goran-mahovlic/Pi5-Artix-FPGA-Hat/PCB/outputs/Pi5-Artix50T-Hat.pdf

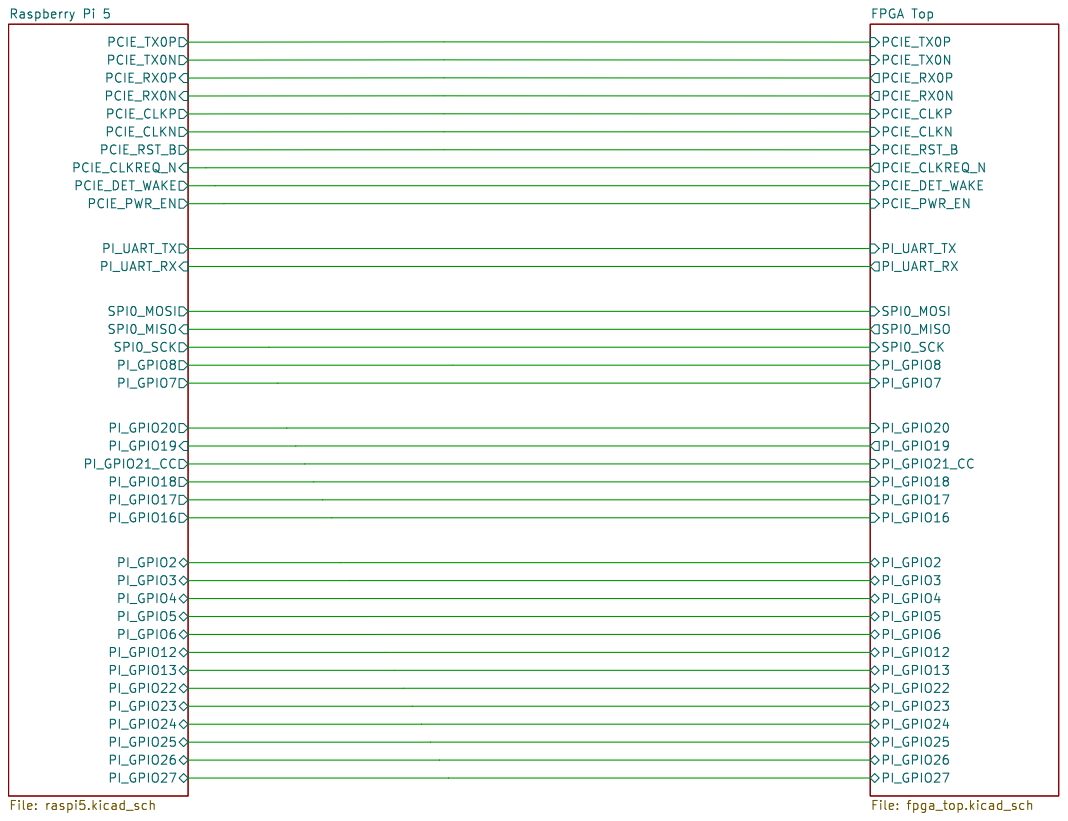
[picture p1: page 1]

https://www.george-smart.co.uk
https://github.com/m1geo/Pi5-Artix-FPGA-Hat

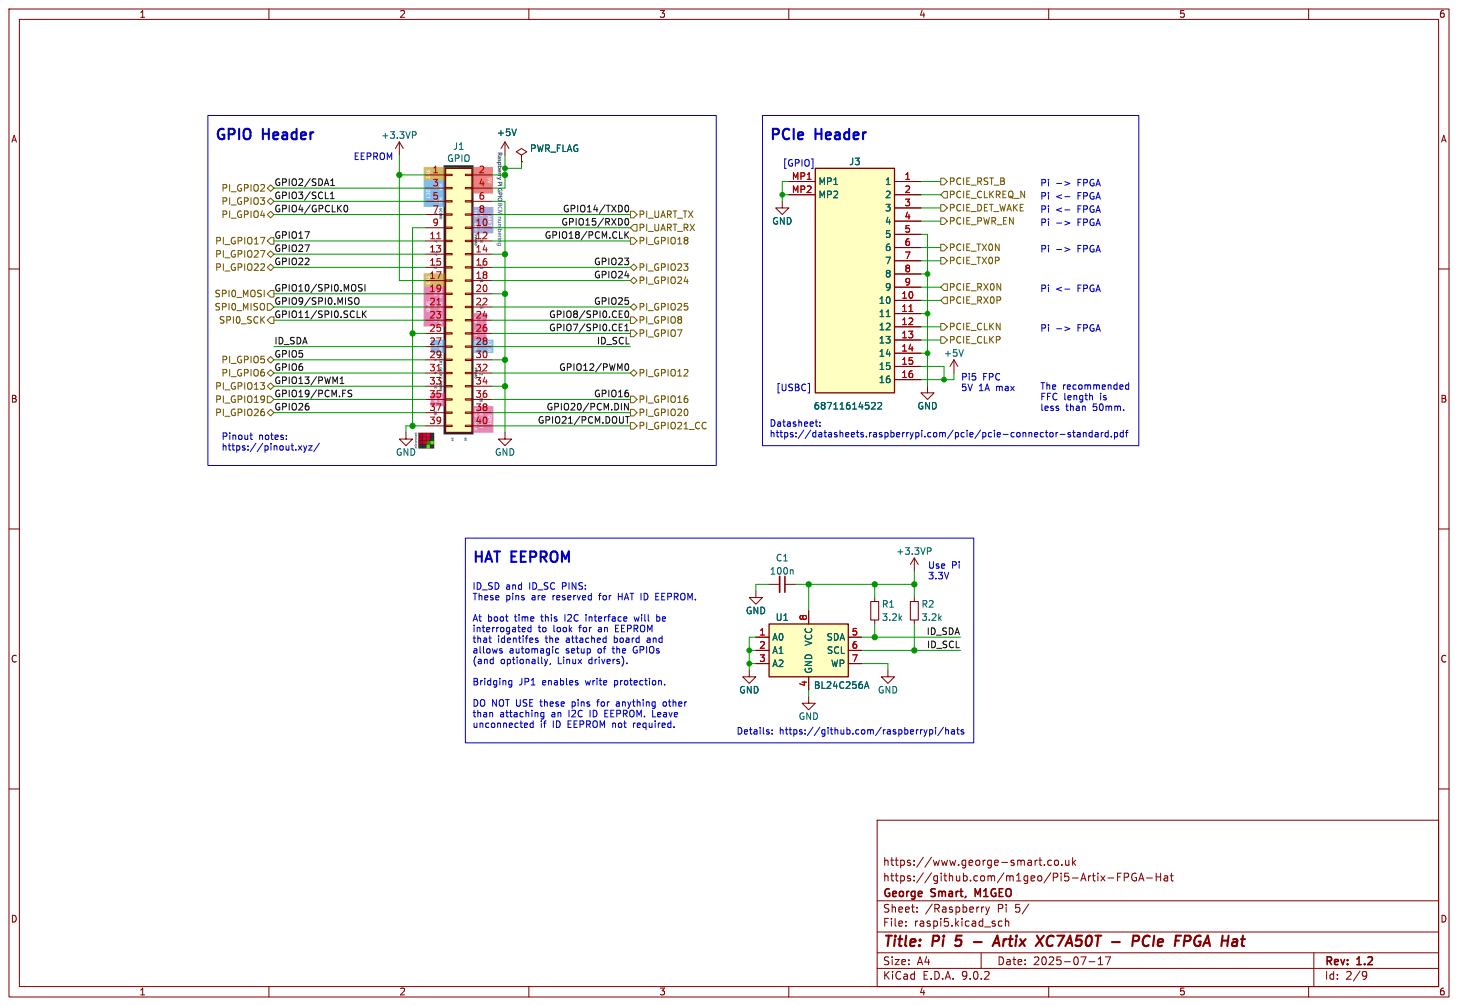
[picture p2: page 2]

4 SDA 5 SCL 6 WP 7 GND GND

The recommended FFC length is

Pinout notes: https://pinout.xyz/

3.2k +3.3VP GND
Details: https://github.com/raspberrypi/hats Use Pi 3.3V

4 SDA 5 SCL 6 WP 7 U1 BL24C256A GND GND

https://github.com/m1geo/Pi5-Artix-FPGA-Hat

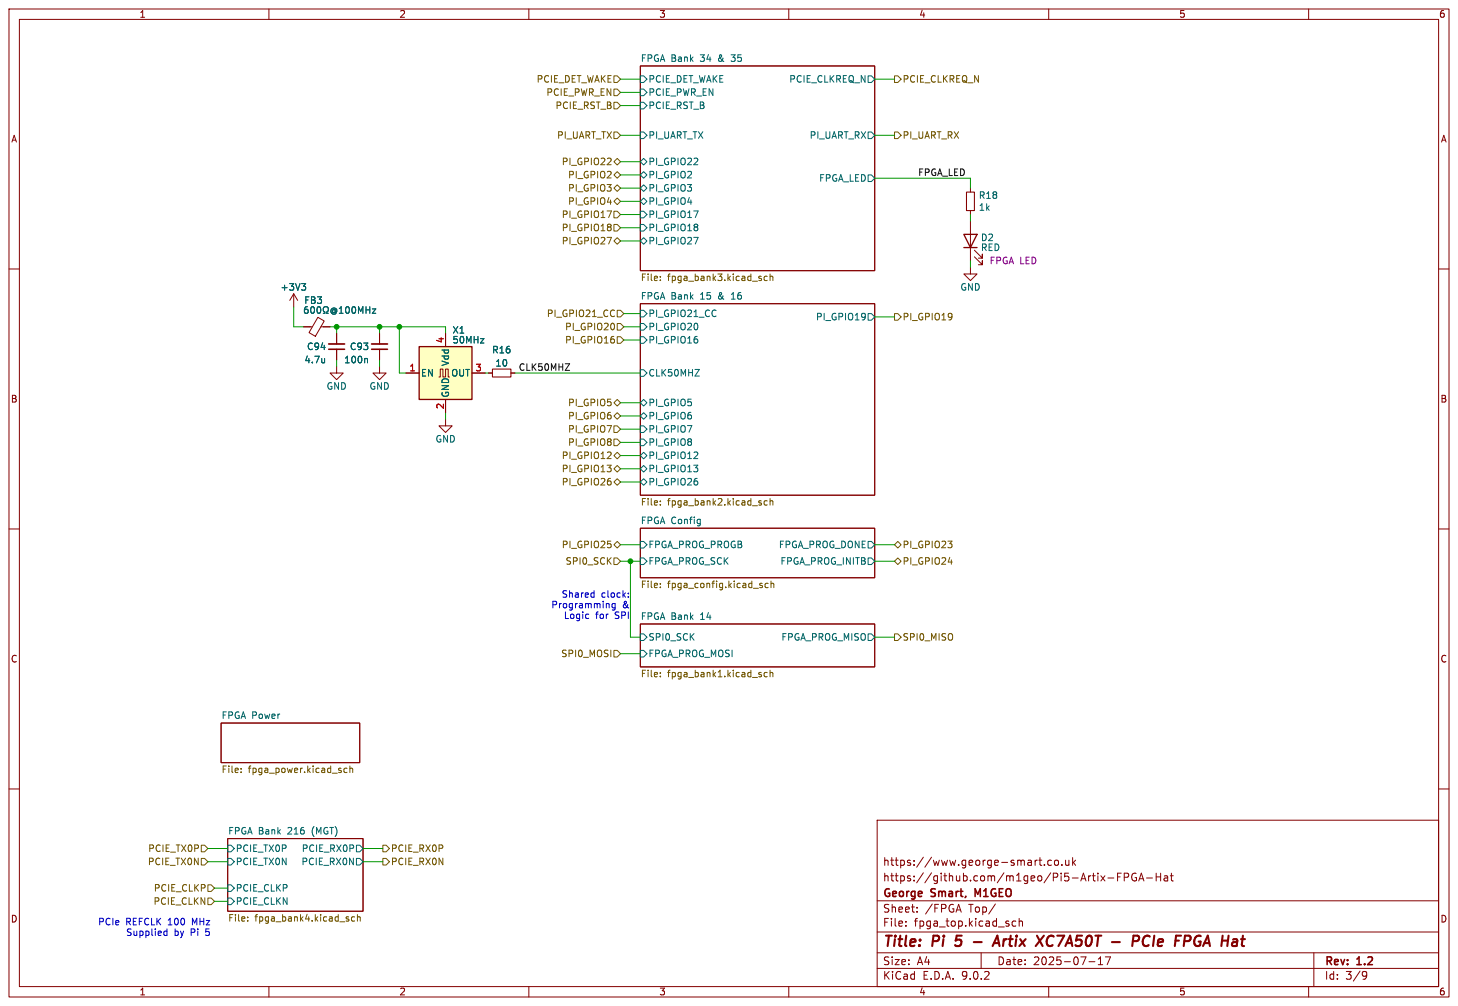
[picture p3: page 3]

Id: 3/9 Title: Pi 5 - Artix XC7A50T - PCIe FPGA Hat File: fpga_top.kicad_sch Sheet: /FPGA Top/

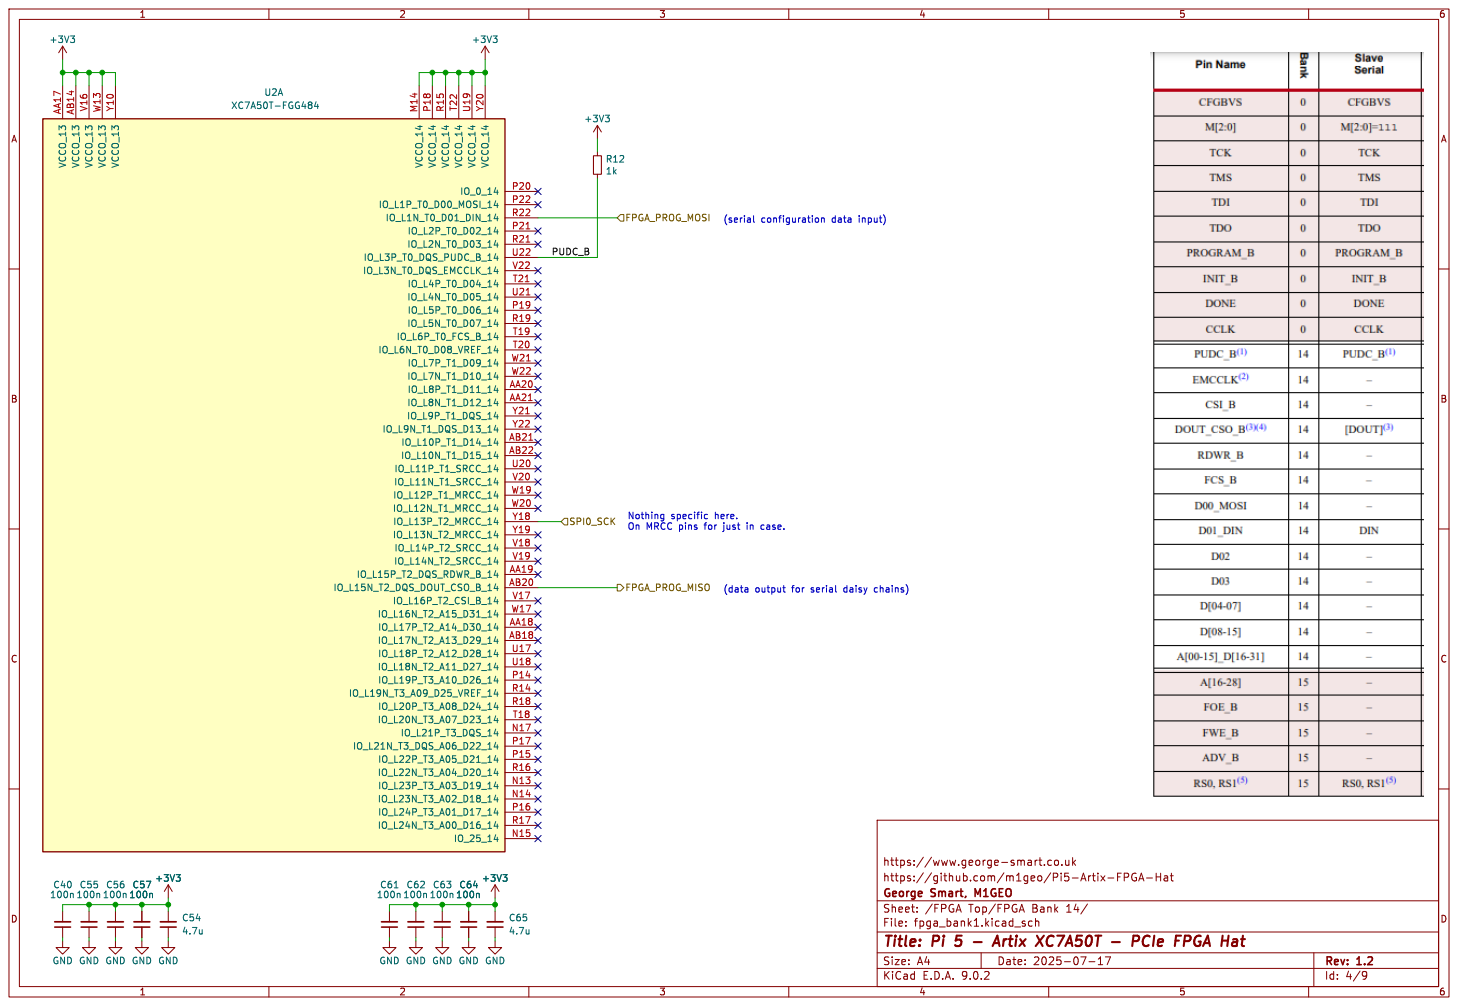
[picture p4: page 4]

https://www.george-smart.co.uk GND

https://github.com/m1geo/Pi5-Artix-FPGA-Hat

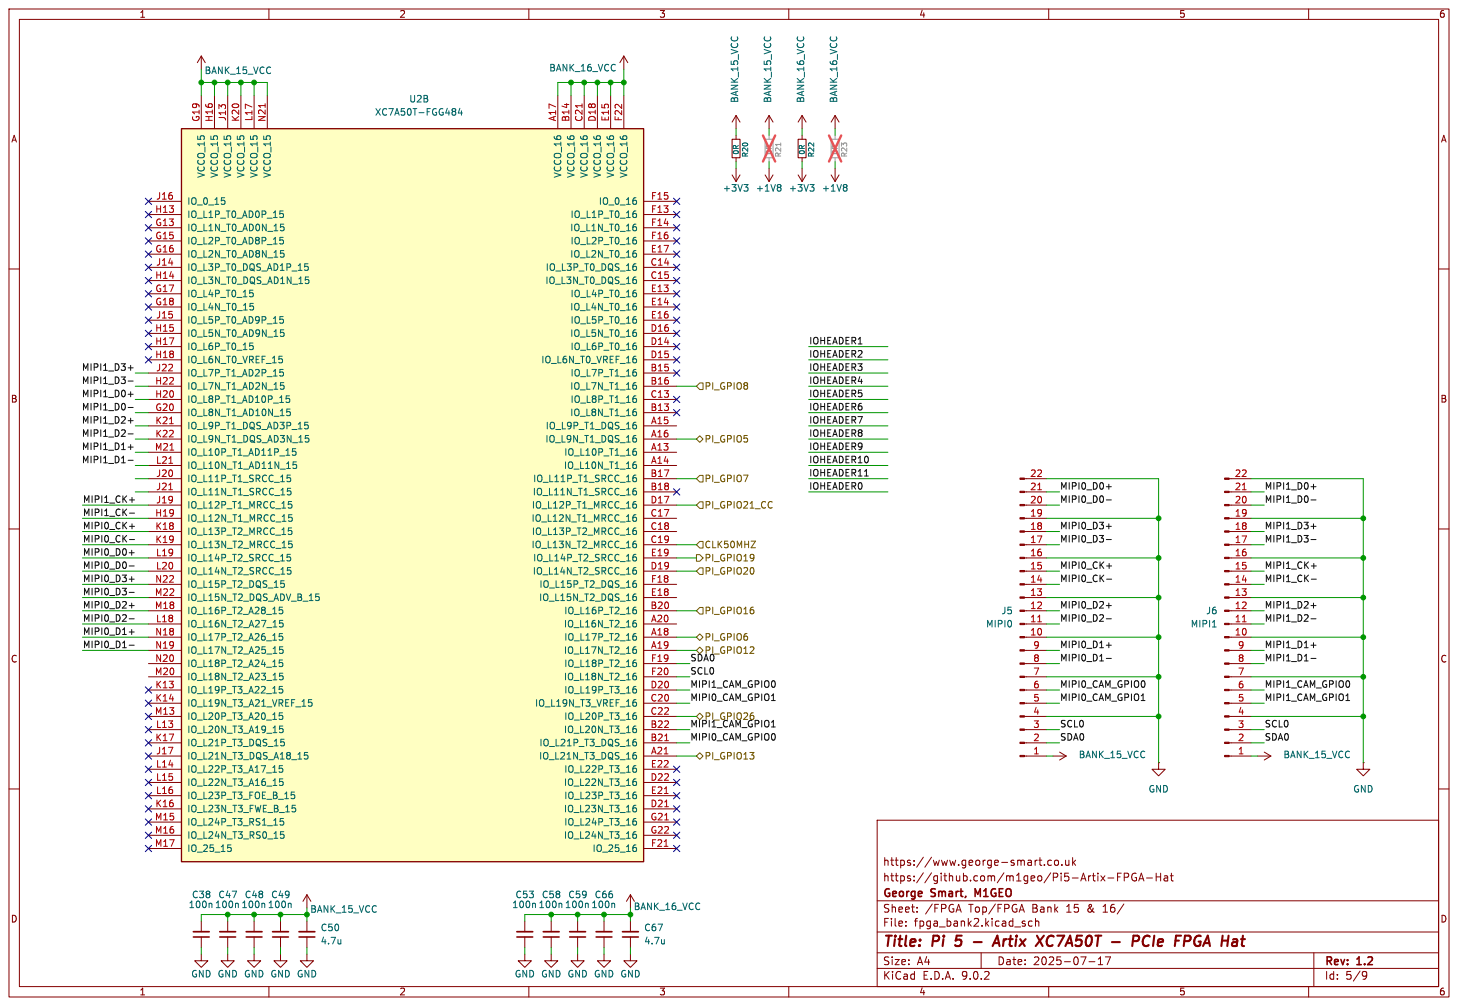
[picture p5: page 5]

https://www.george-smart.co.uk C38

https://github.com/m1geo/Pi5-Artix-FPGA-Hat

GND GND GND GND GND

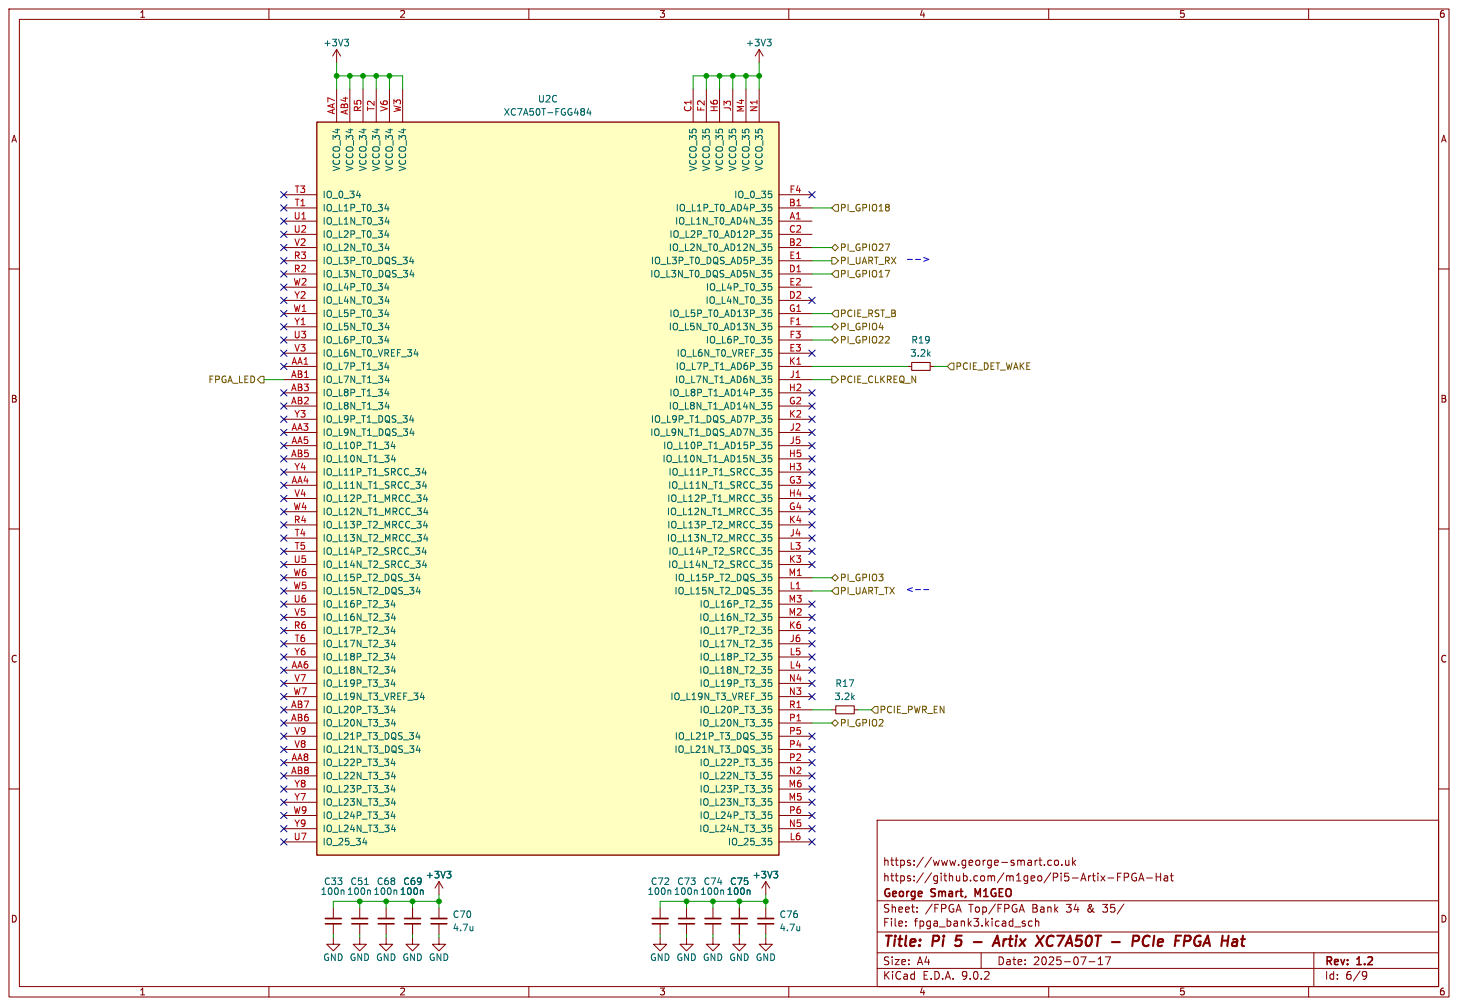
[picture p6: page 6]

https://github.com/m1geo/Pi5-Artix-FPGA-Hat

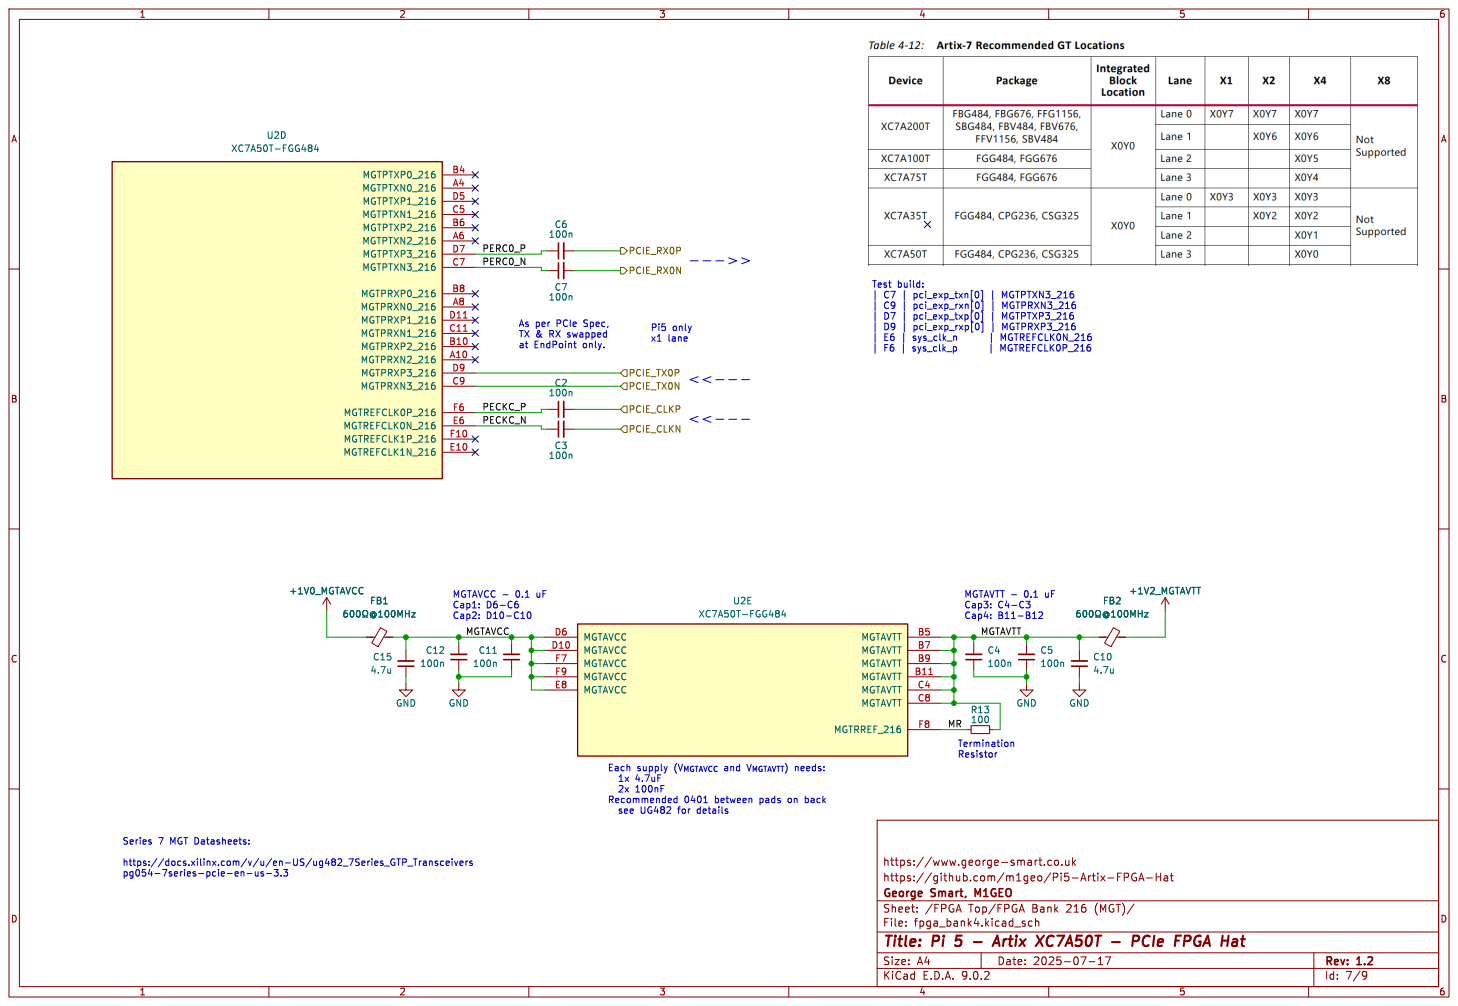
[picture p7: page 7]

As per PCIe Spec, TX & RX swapped

x1 lane Series 7 MGT Datasheets: https://docs.xilinx.com/v/u/en-US/ug482_7Series_GTP_Transceivers

https://www.george-smart.co.uk C3

https://github.com/m1geo/Pi5-Artix-FPGA-Hat

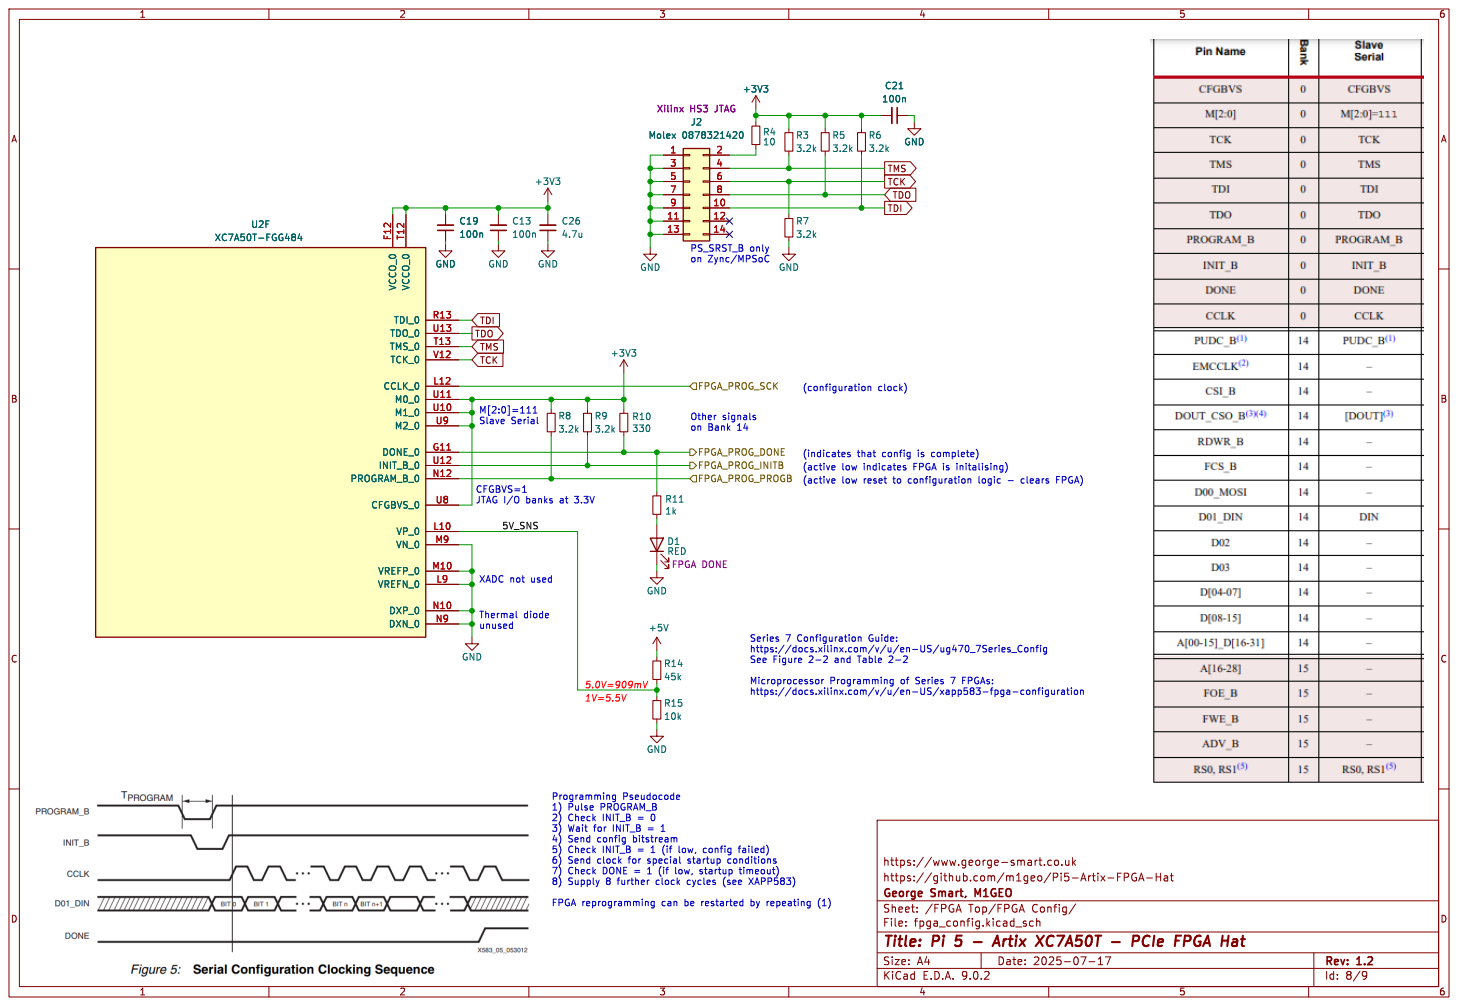
[picture p8: page 8]

https://www.george-smart.co.uk R8

1) Pulse PROGRAM_B
2) Check INIT_B = 0
3) Wait for INIT_B = 1
4) Send config bitstream
5) Check INIT_B = 1 (if low, config failed)
6) Send clock for special startup conditions 7) Check DONE = 1 (if low, startup timeout)

https://github.com/m1geo/Pi5-Artix-FPGA-Hat
Id: 8/9 Title: Pi 5 - Artix XC7A50T - PCIe FPGA Hat File: fpga_config.kicad_sch Sheet: /FPGA Top/FPGA Config/

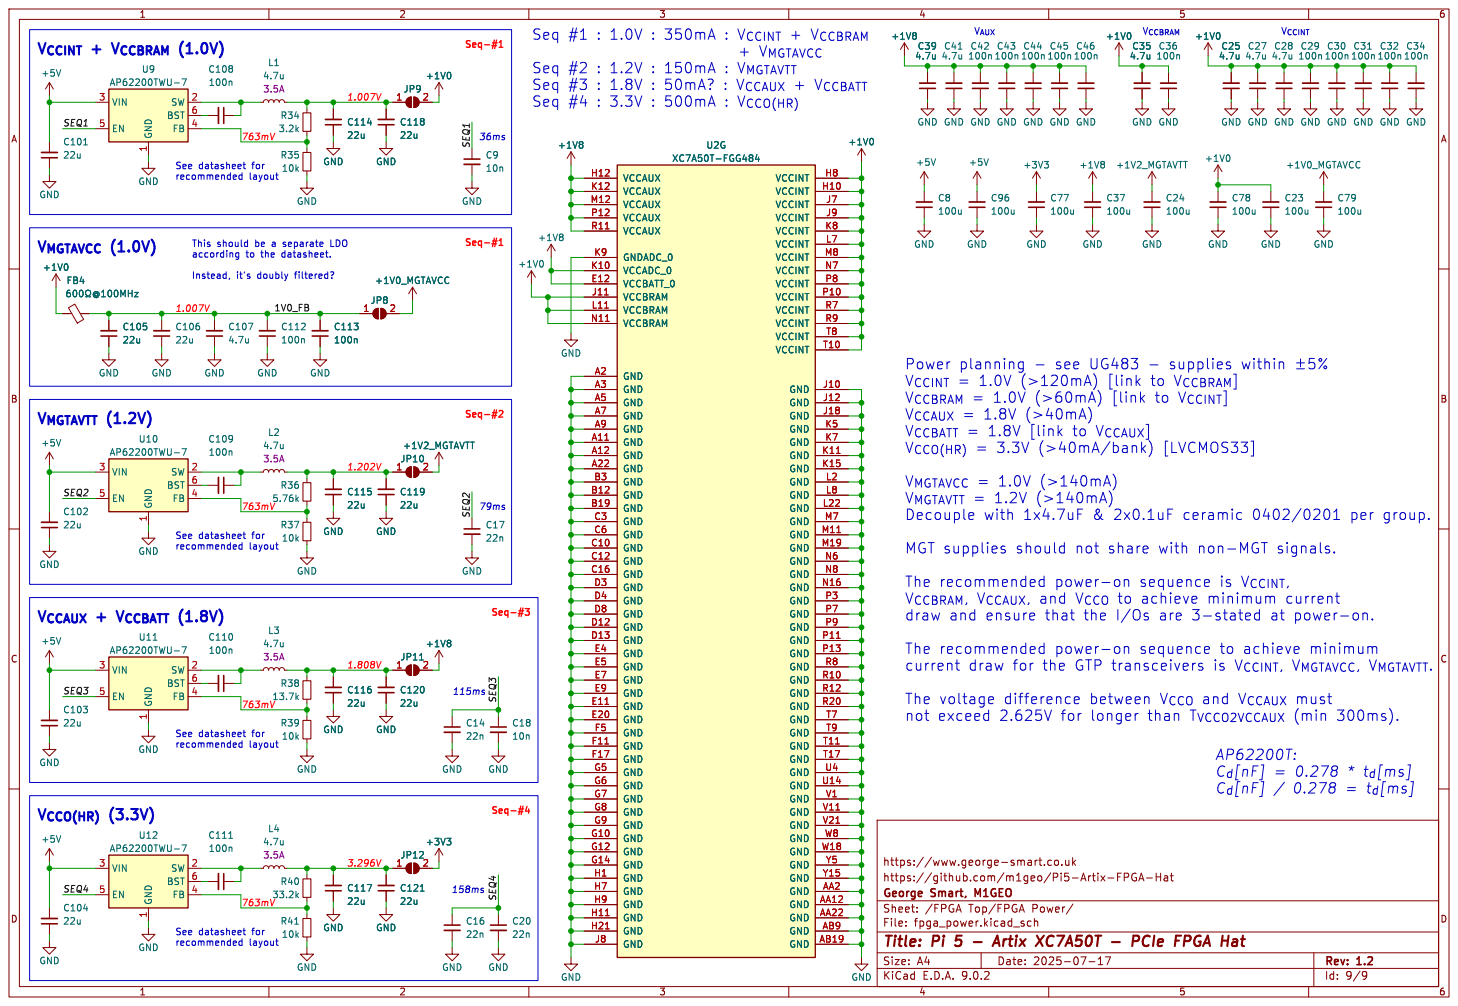
[picture p9: page 9]

1 SW 2 BST 6 FB 4 U9 AP62200TWU-7 GND GND

V_{CCAUX} = 1.8V (>40mA)
V_{CCBATT} = 1.8V [link to V_{CCAUX}]

1 SW 2 BST 6 FB 4 U12 AP62200TWU-7 GND

MGT supplies should not share with non-MGT signals.

V_{CCBRAM}, V_{CCAUX}, and V_{CCO} to achieve minimum current

1 SW 2 BST 6 FB 4 U11 AP62200TWU-7 GND

not exceed 2.625V for longer than T_{VCCO2VCCAUX} (min 300ms).

https://www.george-smart.co.uk
https://github.com/m1geo/Pi5-Artix-FPGA-Hat
