goran-mahovlic/Pi5-Artix-FPGA-Hat/PCB/Pi5-Artix50T-Hat.kicad_pcb

## KiCad design PCB/Pi5-Artix50T-Hat.kicad_pcb (2025-07-19)

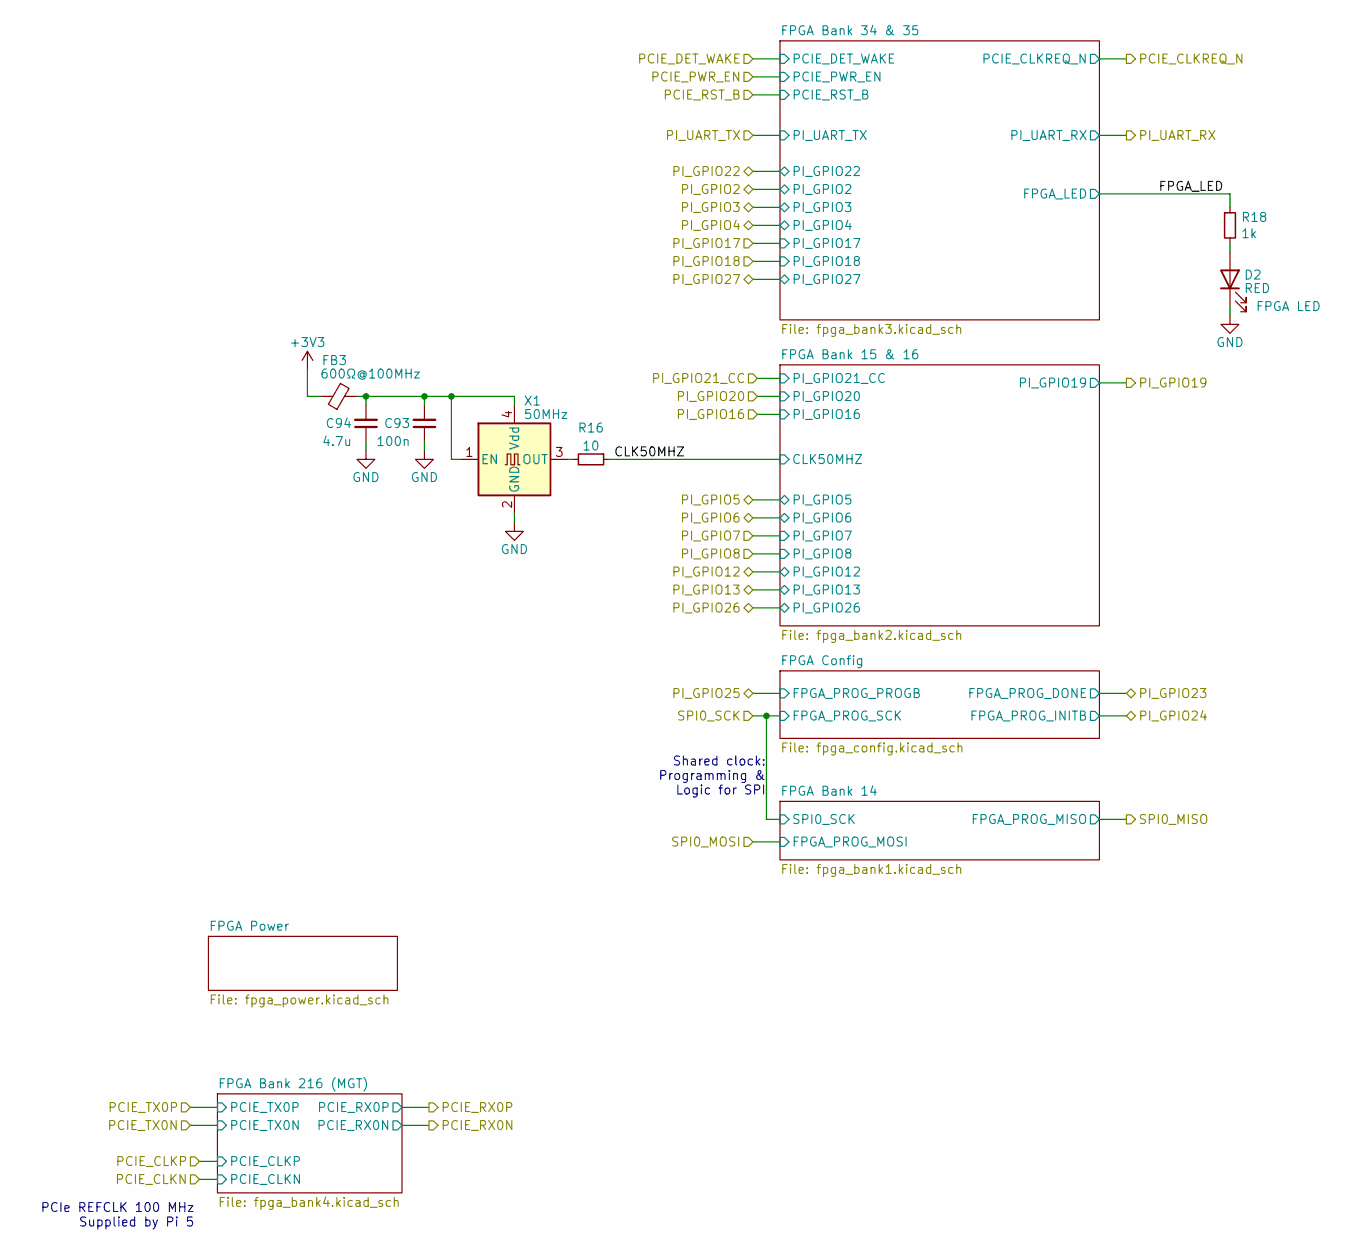
[picture p10: schematic fpga_top.kicad_sch, Pi 5 - Artix XC7A50T - PCIe FPGA Hat]

Parts:
C93: 100n; C_0402_1005Metric; LCSC C1525
C94: 4.7u; C_0402_1005Metric; LCSC C23733
D2: RED; LED_0603_1608Metric; LCSC C965795
FB3: 600Ω@100MHz; L_0603_1608Metric; LCSC C1002
R16: 10; R_0402_1005Metric; LCSC C25077
R18: 1k; R_0402_1005Metric; LCSC C11702
X1: 50MHz; Oscillator_SMD_EuroQuartz_XO32-4Pin_3.2x2.5mm; LCSC C5203552

Connections:
+3V3: FB3.1; also elsewhere on the board
/FPGA Top/CLK50MHZ: R16.1; also elsewhere on the board
/FPGA Top/FPGA_LED: R18.1; also elsewhere on the board
GND: C93.1, C94.1, D2.1 (K), X1.2 (GND); also elsewhere on the board
unnamed: D2.2 (A), R18.2
unnamed: C93.2, C94.2, FB3.2, X1.1 (EN), X1.4 (Vdd)
unnamed: R16.2, X1.3 (OUT)

Notes on the sheet:
Shared clock: Programming & Logic for SPI
PCIe REFCLK 100 MHz Supplied by Pi 5

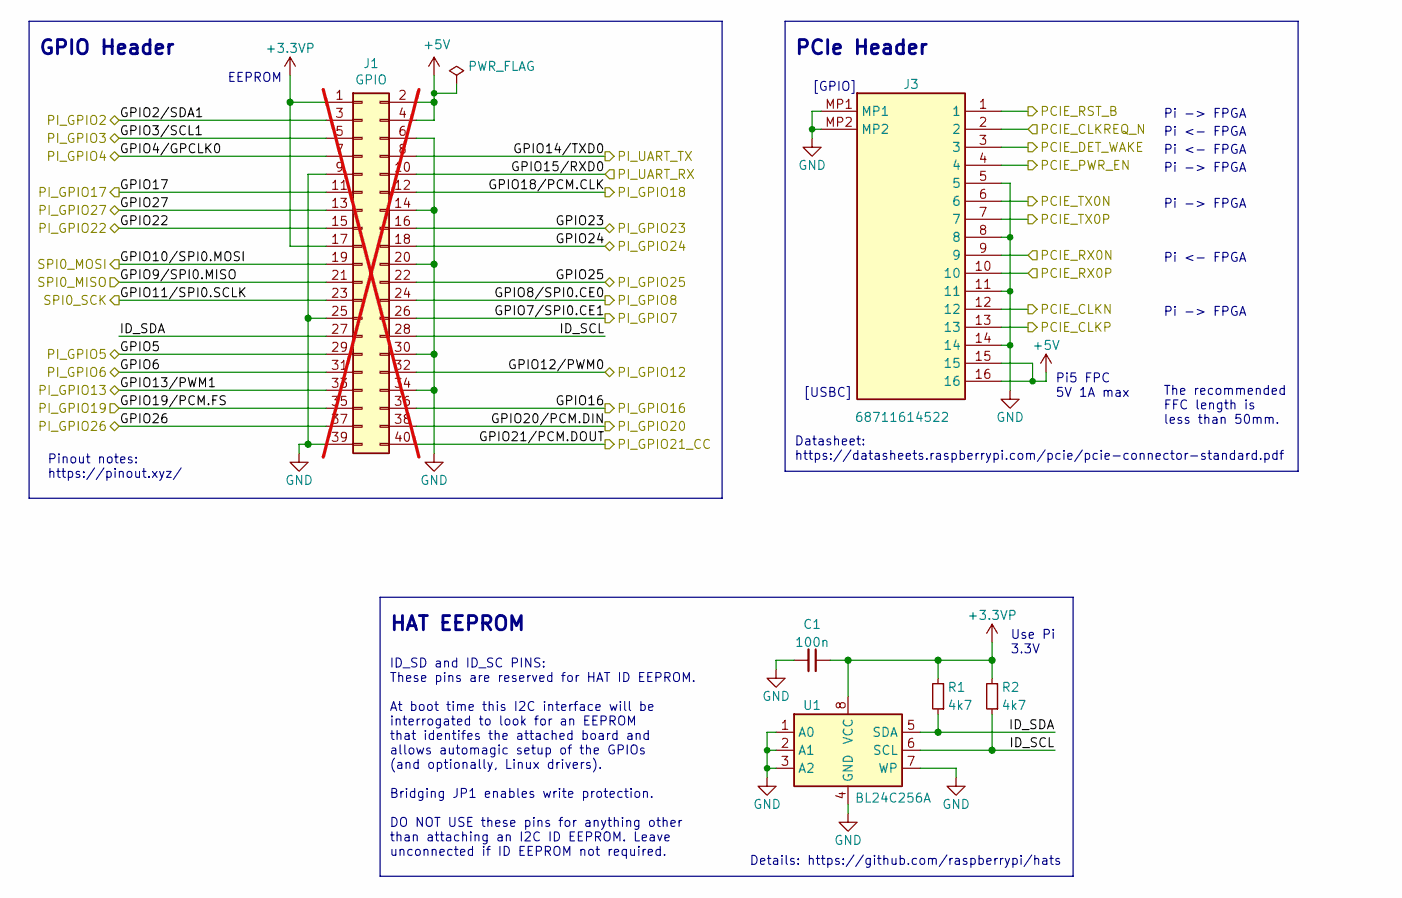
[picture p11: schematic raspi5.kicad_sch, Pi 5 - Artix XC7A50T - PCIe FPGA Hat]

Parts:
C1: 100n; C_0402_1005Metric; LCSC C1525
J1: GPIO; PinSocket_2x20_P2.54mm_Vertical; LCSC C2977589; not fitted
J3: 68711614522; Manufacturer_Part_Number 68711614522; Mouser Part Number 710-68711614522
R1, R2: 4k7; R_0402_1005Metric; LCSC C25900
U1: BL24C256A; TSSOP-8_4.4x3mm_P0.65mm; LCSC C110276

Connections:
+3.3VP: C1.1, J1.1, J1.17, R1.2, R2.2, U1.8 (VCC)
+5V: J1.2, J1.4, J3.15, J3.16; also elsewhere on the board
/FPGA Top/PCIE_CLKN: J3.12; also elsewhere on the board
/FPGA Top/PCIE_CLKP: J3.13; also elsewhere on the board
/FPGA Top/PCIE_CLKREQ_N: J3.2; also elsewhere on the board
/FPGA Top/PCIE_DET_WAKE: J3.3; also elsewhere on the board
/FPGA Top/PCIE_PWR_EN: J3.4; also elsewhere on the board
/FPGA Top/PCIE_RST_B: J3.1; also elsewhere on the board
/FPGA Top/PCIE_RX0N: J3.9; also elsewhere on the board
/FPGA Top/PCIE_RX0P: J3.10; also elsewhere on the board
/FPGA Top/PCIE_TX0N: J3.6; also elsewhere on the board
/FPGA Top/PCIE_TX0P: J3.7; also elsewhere on the board
/Raspberry Pi 5/GPIO2/SDA1: J1.3; also elsewhere on the board
/Raspberry Pi 5/GPIO3/SCL1: J1.5; also elsewhere on the board
/Raspberry Pi 5/GPIO4/GPCLK0: J1.7; also elsewhere on the board
/Raspberry Pi 5/GPIO5: J1.29; also elsewhere on the board
/Raspberry Pi 5/GPIO6: J1.31; also elsewhere on the board
/Raspberry Pi 5/GPIO7/SPI0.CE1: J1.26; also elsewhere on the board
/Raspberry Pi 5/GPIO8/SPI0.CE0: J1.24; also elsewhere on the board
/Raspberry Pi 5/GPIO9/SPI0.MISO: J1.21; also elsewhere on the board
/Raspberry Pi 5/GPIO10/SPI0.MOSI: J1.19; also elsewhere on the board
/Raspberry Pi 5/GPIO11/SPI0.SCLK: J1.23; also elsewhere on the board
/Raspberry Pi 5/GPIO12/PWM0: J1.32; also elsewhere on the board
/Raspberry Pi 5/GPIO13/PWM1: J1.33; also elsewhere on the board
/Raspberry Pi 5/GPIO14/TXD0: J1.8; also elsewhere on the board
/Raspberry Pi 5/GPIO15/RXD0: J1.10; also elsewhere on the board
/Raspberry Pi 5/GPIO16: J1.36; also elsewhere on the board
/Raspberry Pi 5/GPIO17: J1.11; also elsewhere on the board
/Raspberry Pi 5/GPIO18/PCM.CLK: J1.12; also elsewhere on the board
/Raspberry Pi 5/GPIO19/PCM.FS: J1.35; also elsewhere on the board
/Raspberry Pi 5/GPIO20/PCM.DIN: J1.38; also elsewhere on the board
/Raspberry Pi 5/GPIO21/PCM.DOUT: J1.40; also elsewhere on the board
/Raspberry Pi 5/GPIO22: J1.15; also elsewhere on the board
/Raspberry Pi 5/GPIO23: J1.16; also elsewhere on the board
/Raspberry Pi 5/GPIO24: J1.18; also elsewhere on the board
/Raspberry Pi 5/GPIO25: J1.22; also elsewhere on the board
/Raspberry Pi 5/GPIO26: J1.37; also elsewhere on the board
/Raspberry Pi 5/GPIO27: J1.13; also elsewhere on the board
/Raspberry Pi 5/ID_SCL: J1.28, R2.1, U1.6 (SCL)
/Raspberry Pi 5/ID_SDA: J1.27, R1.1, U1.5 (SDA)
GND: C1.2, J1.6, J1.9, J1.14, J1.20, J1.25, J1.30, J1.34, J1.39, J3.5, J3.8, J3.11, J3.14, J3.MP1, J3.MP2, U1.1 (A0), U1.2 (A1), U1.3 (A2), U1.4 (GND), U1.7 (WP); also elsewhere on the board

Notes on the sheet:
Pi <- FPGA
[USBC]
Pinout notes: https://pinout.xyz/
Pi -> FPGA
EEPROM
[GPIO]
The recommended FFC length is less than 50mm.
PCIe Header
ID_SD and ID_SC PINS: These pins are reserved for HAT ID EEPROM. At boot time this I2C interface will be interrogated to look for an EEPROM that identifes the attached board and allows automagic setup of the GPIOs (and optionally, Linux drivers). Bridging JP1 enables write protection. DO NOT USE th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
HAT EEPROM
Datasheet: https://datasheets.raspberrypi.com/pcie/pcie-connector-standard.pdf
Details: https://github.com/raspberrypi/hats
Use Pi 3.3V
Pi5 FPC 5V 1A max
GPIO Header

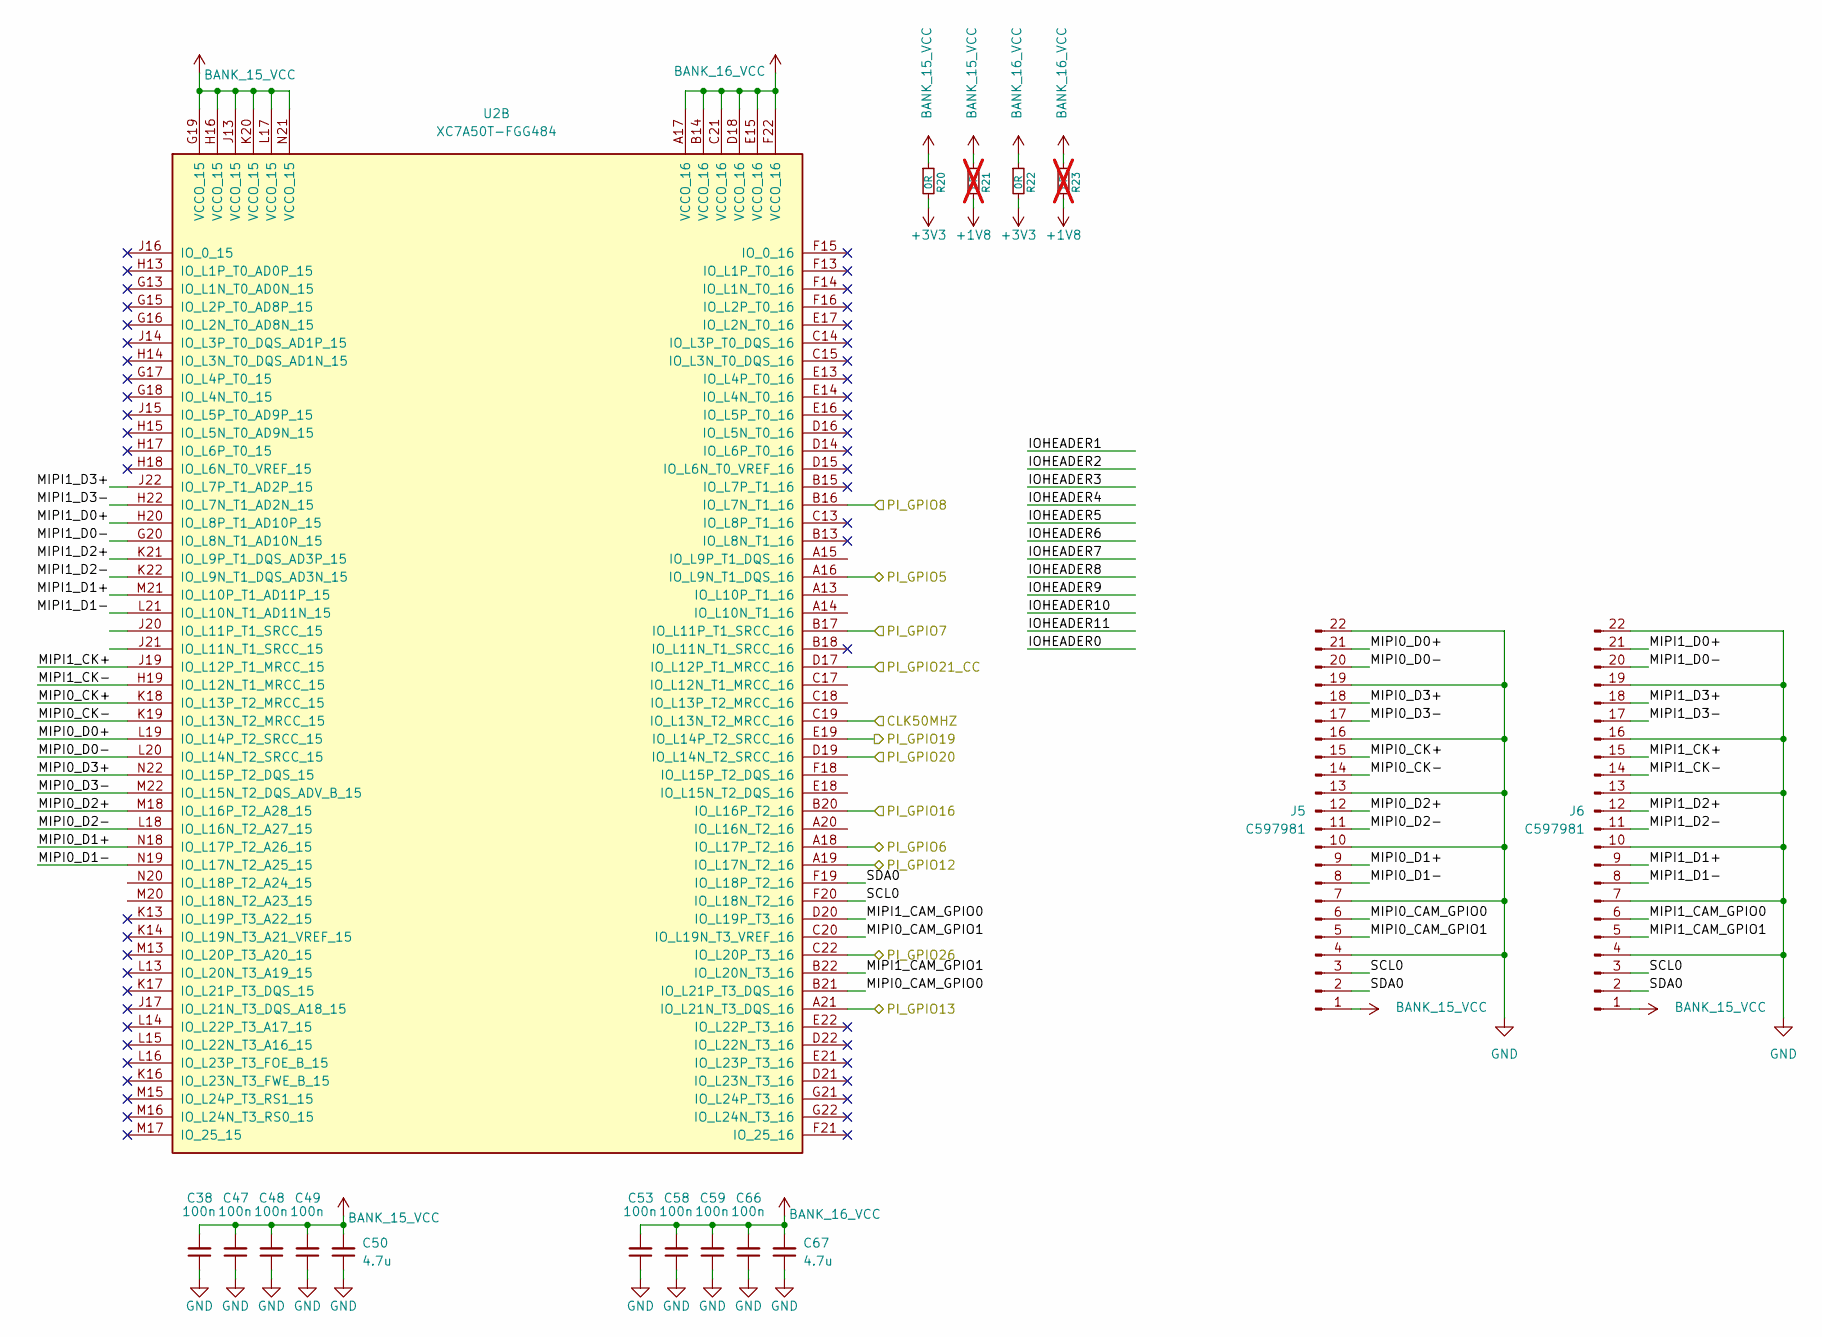
[picture p12: schematic fpga_bank2.kicad_sch, Pi 5 - Artix XC7A50T - PCIe FPGA Hat]

Parts:
C38, C47, C48, C49, C53, C58, C59, C66: 100n; C_0402_1005Metric; LCSC C1525
C50, C67: 4.7u; C_0402_1005Metric; LCSC C23733
J5, J6: C597981; CONN_FH12-22S-0.5SH55_HIR; LCSC C597981
R20, R22: 0R; R_0603_1608Metric
R21, R23: 0R; R_0603_1608Metric; not fitted
U2: XC7A50T-FGG484; Xilinx_FGG484; LCSC C1550658

Connections:
+1V8: R21.2, R23.2; also elsewhere on the board
+3V3: R20.2, R22.2; also elsewhere on the board
/FPGA Top/CLK50MHZ: U2.C19 (IO_L13N_T2_MRCC_16); also elsewhere on the board
/FPGA Top/FPGA Bank 15 & 16/MIPI0_CAM_GPIO0: J5.6, U2.B21 (IO_L21P_T3_DQS_16)
/FPGA Top/FPGA Bank 15 & 16/MIPI0_CAM_GPIO1: J5.5, U2.C20 (IO_L19N_T3_VREF_16)
/FPGA Top/FPGA Bank 15 & 16/MIPI0_CK+: J5.15, U2.K18 (IO_L13P_T2_MRCC_15)
/FPGA Top/FPGA Bank 15 & 16/MIPI0_CK-: J5.14, U2.K19 (IO_L13N_T2_MRCC_15)
/FPGA Top/FPGA Bank 15 & 16/MIPI0_D0+: J5.21, U2.L19 (IO_L14P_T2_SRCC_15)
/FPGA Top/FPGA Bank 15 & 16/MIPI0_D0-: J5.20, U2.L20 (IO_L14N_T2_SRCC_15)
/FPGA Top/FPGA Bank 15 & 16/MIPI0_D1+: J5.9, U2.N18 (IO_L17P_T2_A26_15)
/FPGA Top/FPGA Bank 15 & 16/MIPI0_D1-: J5.8, U2.N19 (IO_L17N_T2_A25_15)
/FPGA Top/FPGA Bank 15 & 16/MIPI0_D2+: J5.12, U2.M18 (IO_L16P_T2_A28_15)
/FPGA Top/FPGA Bank 15 & 16/MIPI0_D2-: J5.11, U2.L18 (IO_L16N_T2_A27_15)
/FPGA Top/FPGA Bank 15 & 16/MIPI0_D3+: J5.18, U2.N22 (IO_L15P_T2_DQS_15)
/FPGA Top/FPGA Bank 15 & 16/MIPI0_D3-: J5.17, U2.M22 (IO_L15N_T2_DQS_ADV_B_15)
/FPGA Top/FPGA Bank 15 & 16/MIPI1_CAM_GPIO0: J6.6, U2.D20 (IO_L19P_T3_16)
/FPGA Top/FPGA Bank 15 & 16/MIPI1_CAM_GPIO1: J6.5, U2.B22 (IO_L20N_T3_16)
/FPGA Top/FPGA Bank 15 & 16/MIPI1_CK+: J6.15, U2.J19 (IO_L12P_T1_MRCC_15)
/FPGA Top/FPGA Bank 15 & 16/MIPI1_CK-: J6.14, U2.H19 (IO_L12N_T1_MRCC_15)
/FPGA Top/FPGA Bank 15 & 16/MIPI1_D0+: J6.21, U2.H20 (IO_L8P_T1_AD10P_15)
/FPGA Top/FPGA Bank 15 & 16/MIPI1_D0-: J6.20, U2.G20 (IO_L8N_T1_AD10N_15)
/FPGA Top/FPGA Bank 15 & 16/MIPI1_D1+: J6.9, U2.M21 (IO_L10P_T1_AD11P_15)
/FPGA Top/FPGA Bank 15 & 16/MIPI1_D1-: J6.8, U2.L21 (IO_L10N_T1_AD11N_15)
/FPGA Top/FPGA Bank 15 & 16/MIPI1_D2+: J6.12, U2.K21 (IO_L9P_T1_DQS_AD3P_15)
/FPGA Top/FPGA Bank 15 & 16/MIPI1_D2-: J6.11, U2.K22 (IO_L9N_T1_DQS_AD3N_15)
/FPGA Top/FPGA Bank 15 & 16/MIPI1_D3+: J6.18, U2.J22 (IO_L7P_T1_AD2P_15)
/FPGA Top/FPGA Bank 15 & 16/MIPI1_D3-: J6.17, U2.H22 (IO_L7N_T1_AD2N_15)
/FPGA Top/FPGA Bank 15 & 16/SCL0: J5.3, J6.3, U2.F20 (IO_L18N_T2_16)
/FPGA Top/FPGA Bank 15 & 16/SDA0: J5.2, J6.2, U2.F19 (IO_L18P_T2_16)
/Raspberry Pi 5/GPIO5: U2.A16 (IO_L9N_T1_DQS_16); also elsewhere on the board
/Raspberry Pi 5/GPIO6: U2.A18 (IO_L17P_T2_16); also elsewhere on the board
/Raspberry Pi 5/GPIO7/SPI0.CE1: U2.B17 (IO_L11P_T1_SRCC_16); also elsewhere on the board
/Raspberry Pi 5/GPIO8/SPI0.CE0: U2.B16 (IO_L7N_T1_16); also elsewhere on the board
/Raspberry Pi 5/GPIO12/PWM0: U2.A19 (IO_L17N_T2_16); also elsewhere on the board
/Raspberry Pi 5/GPIO13/PWM1: U2.A21 (IO_L21N_T3_DQS_16); also elsewhere on the board
/Raspberry Pi 5/GPIO16: U2.B20 (IO_L16P_T2_16); also elsewhere on the board
/Raspberry Pi 5/GPIO19/PCM.FS: U2.E19 (IO_L14P_T2_SRCC_16); also elsewhere on the board
/Raspberry Pi 5/GPIO20/PCM.DIN: U2.D19 (IO_L14N_T2_SRCC_16); also elsewhere on the board
/Raspberry Pi 5/GPIO21/PCM.DOUT: U2.D17 (IO_L12P_T1_MRCC_16); also elsewhere on the board
/Raspberry Pi 5/GPIO26: U2.C22 (IO_L20P_T3_16); also elsewhere on the board
BANK_15_VCC: C38.2, C47.2, C48.2, C49.2, C50.2, J5.1, J6.1, R20.1, R21.1, U2.G19 (VCCO_15), U2.H16 (VCCO_15), U2.J13 (VCCO_15), U2.K20 (VCCO_15), U2.L17 (VCCO_15), U2.N21 (VCCO_15)
BANK_16_VCC: C53.2, C58.2, C59.2, C66.2, C67.2, R22.1, R23.1, U2.A17 (VCCO_16), U2.B14 (VCCO_16), U2.C21 (VCCO_16), U2.D18 (VCCO_16), U2.E15 (VCCO_16), U2.F22 (VCCO_16)
GND: C38.1, C47.1, C48.1, C49.1, C50.1, C53.1, C58.1, C59.1, C66.1, C67.1, J5.4, J5.7, J5.10, J5.13, J5.16, J5.19, J5.22, J6.4, J6.7, J6.10, J6.13, J6.16, J6.19, J6.22; also elsewhere on the board

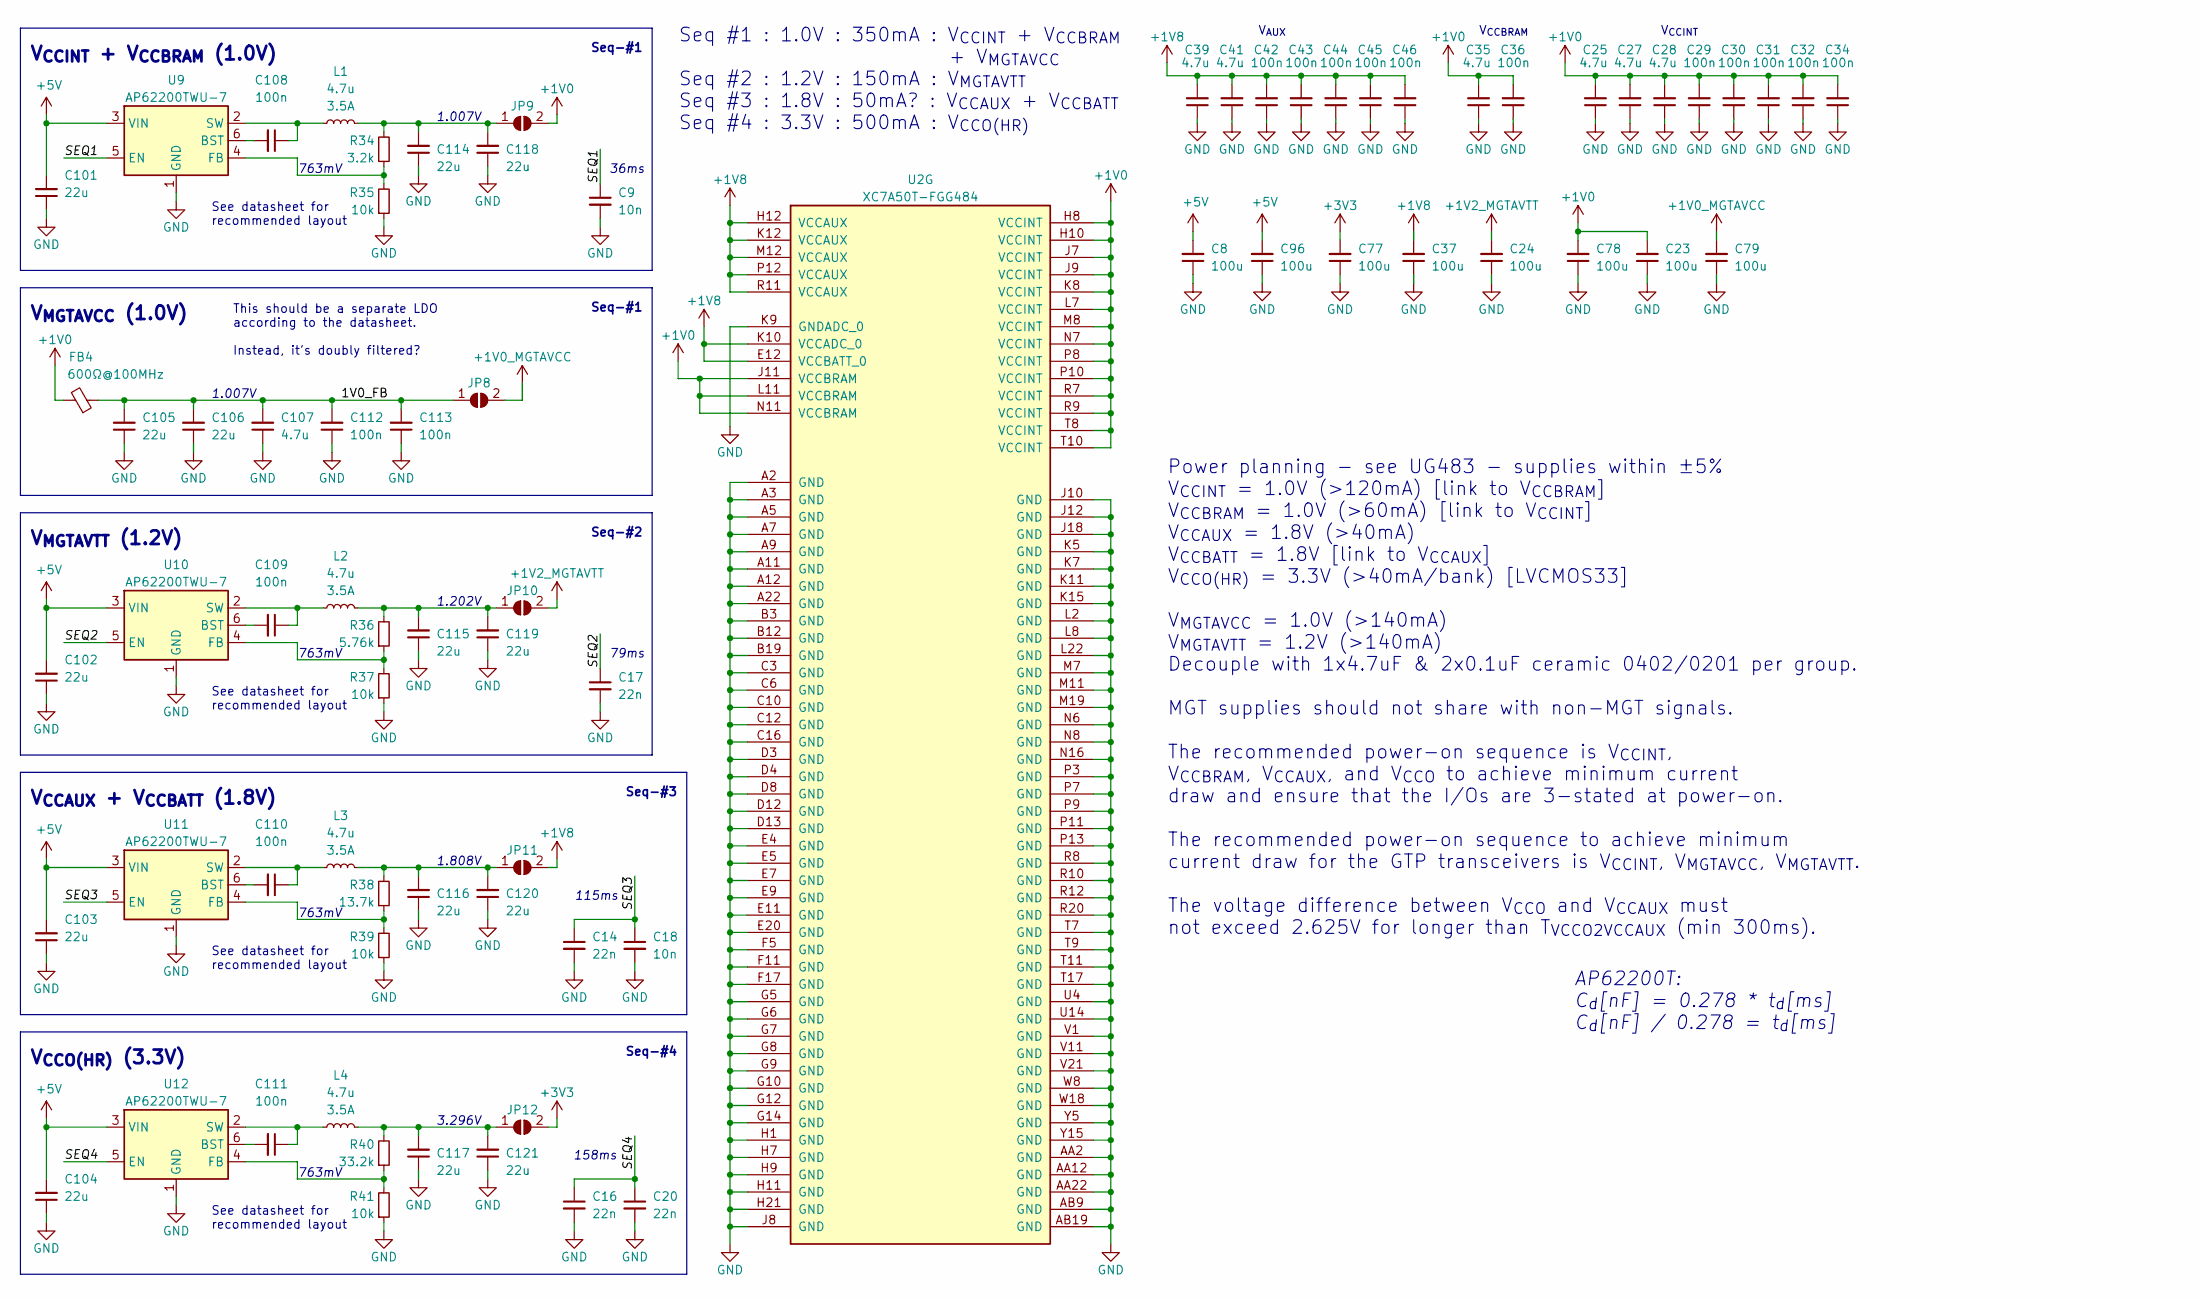
[picture p13: schematic fpga_power.kicad_sch, Pi 5 - Artix XC7A50T - PCIe FPGA Hat]

Parts:
C8, C23, C24, C37, C77, C78, C79, C96: 100u; C_1206_3216Metric; LCSC C15008
C9, C18: 10n; C_0402_1005Metric; LCSC C15195
C14, C16, C17, C20: 22n; C_0402_1005Metric; LCSC C1532
C25, C27, C28, C35, C39, C41, C107: 4.7u; C_0402_1005Metric; LCSC C23733
C29, C30, C31, C32, C34, C36, C42, C43, C44, C45, C46, C108, C109, C110, C111, C112, C113: 100n; C_0402_1005Metric; LCSC C1525
C101, C102, C103, C104, C105, C106, C114, C115, C116, C117, C118, C119, C120, C121: 22u; C_0805_2012Metric; LCSC C45783
FB4: 600Ω@100MHz; L_0603_1608Metric; LCSC C1002
JP8, JP9, JP10, JP11, JP12: JUMPER; SolderJumper-2_P1.3mm_Open_TrianglePad1.0x1.5mm; LCSC C17888
L1, L2, L3, L4: 4.7u; L_Chilisin_BMRB00050518; MPN FAUL0518-4R7MT; LCSC C5298213
R34: 3.2k; R_0402_1005Metric; LCSC C853935
R35, R37, R39, R41: 10k; R_0402_1005Metric; LCSC C25744
R36: 5.76k; R_0402_1005Metric; LCSC C25910
R38: 13.7k; R_0402_1005Metric; LCSC C25854
R40: 33.2k; R_0402_1005Metric; LCSC C122548
U2: XC7A50T-FGG484; Xilinx_FGG484; LCSC C1550658
U9, U10, U11, U12: AP62200TWU-7; TSOT-23-6; LCSC C2895288

Connections:
+1V0: C23.2, C25.2, C27.2, C28.2, C29.2, C30.2, C31.2, C32.2, C34.2, C35.2, C36.2, C78.2, FB4.2, JP9.2 (B), U2.H8 (VCCINT), U2.H10 (VCCINT), U2.J7 (VCCINT), U2.J9 (VCCINT), U2.J11 (VCCBRAM), U2.K8 (VCCINT), U2.L7 (VCCINT), U2.L11 (VCCBRAM), U2.M8 (VCCINT), U2.N7 (VCCINT), U2.N11 (VCCBRAM), U2.P8 (VCCINT), U2.P10 (VCCINT), U2.R7 (VCCINT), U2.R9 (VCCINT), U2.T8 (VCCINT), U2.T10 (VCCINT)
+1V0_MGTAVCC: C79.2, JP8.2 (B); also elsewhere on the board
+1V2_MGTAVTT: C24.2, JP10.2 (B); also elsewhere on the board
+1V8: C37.2, C39.2, C41.2, C42.2, C43.2, C44.2, C45.2, C46.2, JP11.2 (B), U2.E12 (VCCBATT_0), U2.H12 (VCCAUX), U2.K10 (VCCADC_0), U2.K12 (VCCAUX), U2.M12 (VCCAUX), U2.P12 (VCCAUX), U2.R11 (VCCAUX); also elsewhere on the board
+3V3: C77.2, JP12.2 (B); also elsewhere on the board
+5V: C8.2, C96.2, C101.2, C102.2, C103.2, C104.2, U9.3 (VIN), U10.3 (VIN), U11.3 (VIN), U12.3 (VIN); also elsewhere on the board
/FPGA Top/FPGA Power/1V0_FB: C105.2, C106.2, C107.2, C112.2, C113.2, FB4.1, JP8.1 (A)
/FPGA Top/FPGA Power/SEQ1: C9.1, U9.5 (EN)
/FPGA Top/FPGA Power/SEQ2: C17.1, U10.5 (EN)
/FPGA Top/FPGA Power/SEQ3: C14.1, C18.1, U11.5 (EN)
/FPGA Top/FPGA Power/SEQ4: C16.1, C20.1, U12.5 (EN)
GND: C8.1, C9.2, C14.2, C16.2, C17.2, C18.2, C20.2, C23.1, C24.1, C25.1, C27.1, C28.1, C29.1, C30.1, C31.1, C32.1, C34.1, C35.1, C36.1, C37.1, C39.1, C41.1, C42.1, C43.1, C44.1, C45.1, C46.1, C77.1, C78.1, C79.1, C96.1, C101.1, C102.1, C103.1, C104.1, C105.1, C106.1, C107.1, C112.1, C113.1, C114.1, C115.1, C116.1, C117.1, C118.1, C119.1, C120.1, C121.1, R35.1, R37.1, R39.1, R41.1, U2.A2 (GND), U2.A3 (GND), U2.A5 (GND), U2.A7 (GND), U2.A9 (GND), U2.A11 (GND), U2.A12 (GND), U2.A22 (GND), U2.AA2 (GND), U2.AA12 (GND), U2.AA22 (GND), U2.AB9 (GND), U2.AB19 (GND), U2.B3 (GND), U2.B12 (GND), U2.B19 (GND), U2.C3 (GND), U2.C6 (GND), U2.C10 (GND), U2.C12 (GND), U2.C16 (GND), U2.D3 (GND), U2.D4 (GND), U2.D8 (GND), U2.D12 (GND), U2.D13 (GND), U2.E4 (GND), U2.E5 (GND), U2.E7 (GND), U2.E9 (GND), U2.E11 (GND), U2.E20 (GND), U2.F5 (GND), U2.F11 (GND), U2.F17 (GND), U2.G5 (GND), U2.G6 (GND), U2.G7 (GND), U2.G8 (GND), U2.G9 (GND), U2.G10 (GND), U2.G12 (GND), U2.G14 (GND), U2.H1 (GND), U2.H7 (GND), U2.H9 (GND), U2.H11 (GND), U2.H21 (GND), U2.J8 (GND), U2.J10 (GND), U2.J12 (GND), U2.J18 (GND), U2.K5 (GND), U2.K7 (GND), U2.K9 (GNDADC_0), U2.K11 (GND), U2.K15 (GND), U2.L2 (GND), U2.L8 (GND), U2.L22 (GND), U2.M7 (GND), U2.M11 (GND), U2.M19 (GND), U2.N6 (GND), U2.N8 (GND), U2.N16 (GND), U2.P3 (GND), U2.P7 (GND), U2.P9 (GND), U2.P11 (GND), U2.P13 (GND), U2.R8 (GND), U2.R10 (GND), U2.R12 (GND), U2.R20 (GND), U2.T7 (GND), U2.T9 (GND), U2.T11 (GND), U2.T17 (GND), U2.U4 (GND), U2.U14 (GND), U2.V1 (GND), U2.V11 (GND), U2.V21 (GND), U2.W8 (GND), U2.W18 (GND), U2.Y5 (GND), U2.Y15 (GND), U9.1 (GND), U10.1 (GND), U11.1 (GND), U12.1 (GND); also elsewhere on the board
unnamed: C114.2, C118.2, JP9.1 (A), L1.2, R34.2
unnamed: C115.2, C119.2, JP10.1 (A), L2.2, R36.2
unnamed: C116.2, C120.2, JP11.1 (A), L3.2, R38.2
unnamed: C117.2, C121.2, JP12.1 (A), L4.2, R40.2
unnamed: C108.2, U9.6 (BST)
unnamed: R34.1, R35.2, U9.4 (FB)
unnamed: C108.1, L1.1, U9.2 (SW)
unnamed: C109.2, U10.6 (BST)
unnamed: R36.1, R37.2, U10.4 (FB)
unnamed: C109.1, L2.1, U10.2 (SW)
unnamed: C110.2, U11.6 (BST)
unnamed: R38.1, R39.2, U11.4 (FB)
unnamed: C110.1, L3.1, U11.2 (SW)
unnamed: C111.2, U12.6 (BST)
unnamed: R40.1, R41.2, U12.4 (FB)
unnamed: C111.1, L4.1, U12.2 (SW)

Notes on the sheet:
Seq-#1
1.202V
763mV
V_{CCBRAM}
V_{AUX}
1.808V
79ms
115ms
1.007V
Seq #1 : 1.0V : 350mA : V_{CCINT} + V_{CCBRAM} + V_{MGTAVCC} Seq #2 : 1.2V : 150mA : V_{MGTAVTT} Seq #3 : 1.8V : 50mA? : V_{CCAUX} + V_{CCBATT} Seq #4 : 3.3V : 500mA : V_{CCO(HR)}
V_{MGTAVTT} (1.2V)
V_{CCO(HR)} (3.3V)
V_{CCINT}
V_{MGTAVCC} (1.0V)
158ms
See datasheet for recommended layout
V_{CCINT} + V_{CCBRAM} (1.0V)
3.296V
Seq-#3
This should be a separate LDO according to the datasheet. Instead, it's doubly filtered?
36ms
Seq-#4
V_{CCAUX} + V_{CCBATT} (1.8V)
AP62200T: C_{d}[nF] = 0.278 * t_{d}[ms] C_{d}[nF] / 0.278 = t_{d}[ms]
Power planning - see UG483 - supplies within ±5% V_{CCINT} = 1.0V (>120mA) [link to V_{CCBRAM}] V_{CCBRAM} = 1.0V (>60mA) [link to V_{CCINT}] V_{CCAUX} = 1.8V (>40mA) V_{CCBATT} = 1.8V [link to V_{CCAUX}] V_{CCO(HR)} = 3.3V (>40mA/bank) [LVCMOS33] V_{MGTAVCC} = 1.0V (>140mA) V_{MGTAVTT} = 1.2V (>14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
Seq-#2

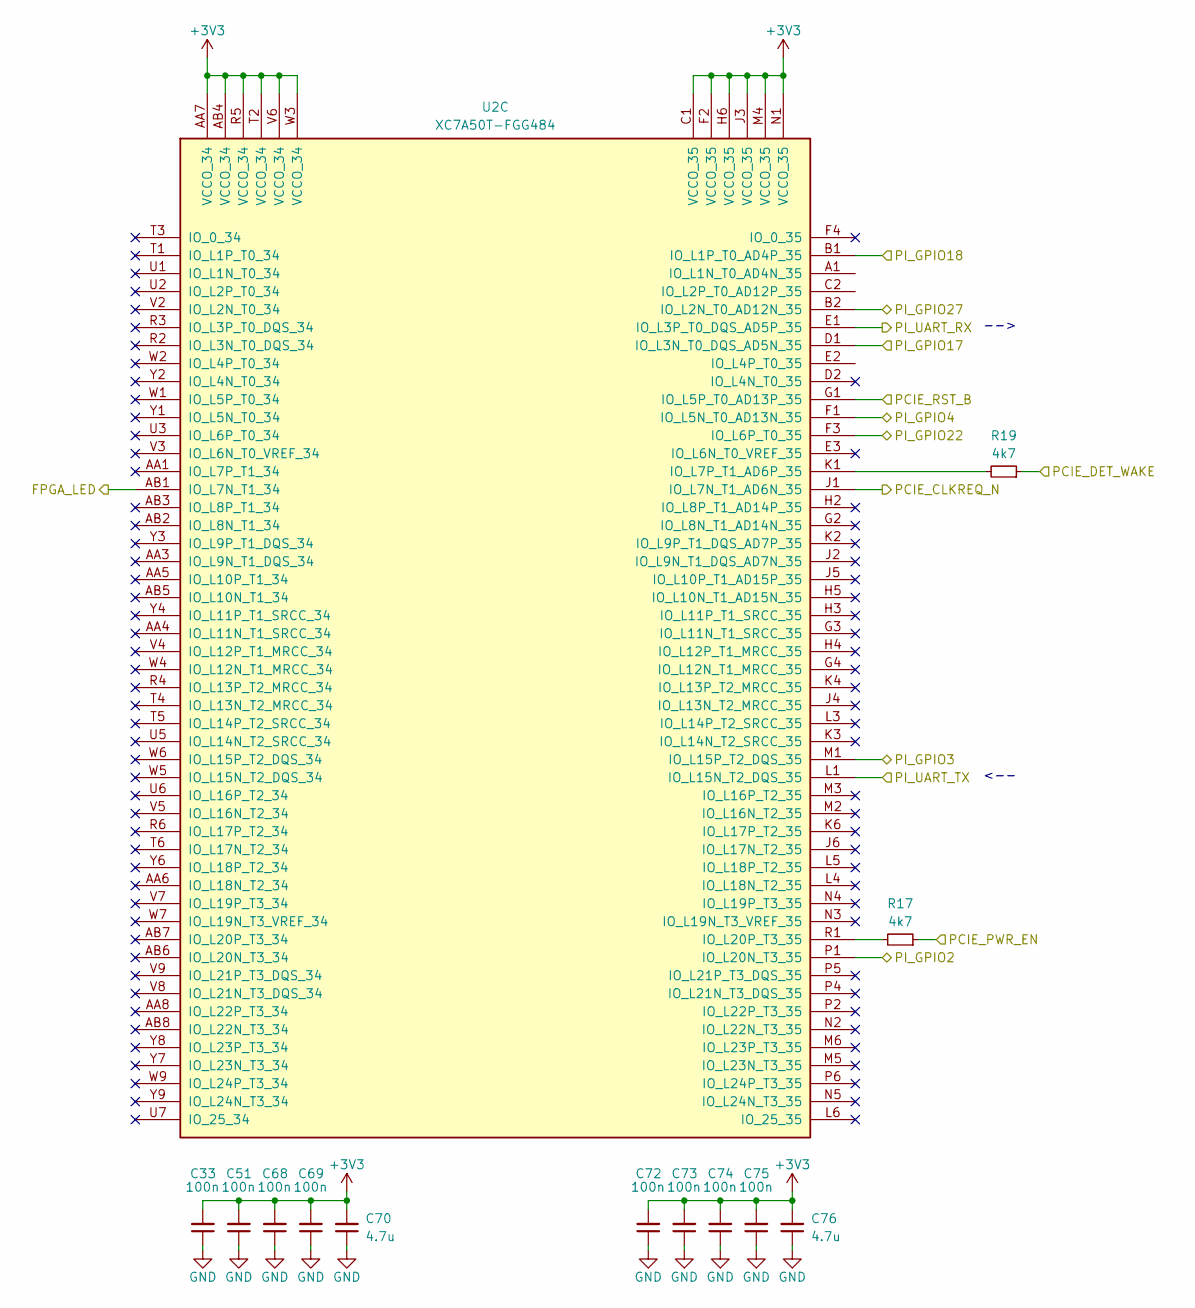
[picture p14: schematic fpga_bank3.kicad_sch, Pi 5 - Artix XC7A50T - PCIe FPGA Hat]

Parts:
C33, C51, C68, C69, C72, C73, C74, C75: 100n; C_0402_1005Metric; LCSC C1525
C70, C76: 4.7u; C_0402_1005Metric; LCSC C23733
R17, R19: 4k7; R_0402_1005Metric; LCSC C25900
U2: XC7A50T-FGG484; Xilinx_FGG484; LCSC C1550658

Connections:
+3V3: C33.2, C51.2, C68.2, C69.2, C70.2, C72.2, C73.2, C74.2, C75.2, C76.2, U2.AA7 (VCCO_34), U2.AB4 (VCCO_34), U2.C1 (VCCO_35), U2.F2 (VCCO_35), U2.H6 (VCCO_35), U2.J3 (VCCO_35), U2.M4 (VCCO_35), U2.N1 (VCCO_35), U2.R5 (VCCO_34), U2.T2 (VCCO_34), U2.V6 (VCCO_34), U2.W3 (VCCO_34); also elsewhere on the board
/FPGA Top/FPGA_LED: U2.AB1 (IO_L7N_T1_34); also elsewhere on the board
/FPGA Top/PCIE_CLKREQ_N: U2.J1 (IO_L7N_T1_AD6N_35); also elsewhere on the board
/FPGA Top/PCIE_DET_WAKE: R19.1; also elsewhere on the board
/FPGA Top/PCIE_PWR_EN: R17.1; also elsewhere on the board
/FPGA Top/PCIE_RST_B: U2.G1 (IO_L5P_T0_AD13P_35); also elsewhere on the board
/Raspberry Pi 5/GPIO2/SDA1: U2.P1 (IO_L20N_T3_35); also elsewhere on the board
/Raspberry Pi 5/GPIO3/SCL1: U2.M1 (IO_L15P_T2_DQS_35); also elsewhere on the board
/Raspberry Pi 5/GPIO4/GPCLK0: U2.F1 (IO_L5N_T0_AD13N_35); also elsewhere on the board
/Raspberry Pi 5/GPIO14/TXD0: U2.L1 (IO_L15N_T2_DQS_35); also elsewhere on the board
/Raspberry Pi 5/GPIO15/RXD0: U2.E1 (IO_L3P_T0_DQS_AD5P_35); also elsewhere on the board
/Raspberry Pi 5/GPIO17: U2.D1 (IO_L3N_T0_DQS_AD5N_35); also elsewhere on the board
/Raspberry Pi 5/GPIO18/PCM.CLK: U2.B1 (IO_L1P_T0_AD4P_35); also elsewhere on the board
/Raspberry Pi 5/GPIO22: U2.F3 (IO_L6P_T0_35); also elsewhere on the board
/Raspberry Pi 5/GPIO27: U2.B2 (IO_L2N_T0_AD12N_35); also elsewhere on the board
GND: C33.1, C51.1, C68.1, C69.1, C70.1, C72.1, C73.1, C74.1, C75.1, C76.1; also elsewhere on the board
unnamed: R19.2, U2.K1 (IO_L7P_T1_AD6P_35)
unnamed: R17.2, U2.R1 (IO_L20P_T3_35)

Notes on the sheet:
-->
<--

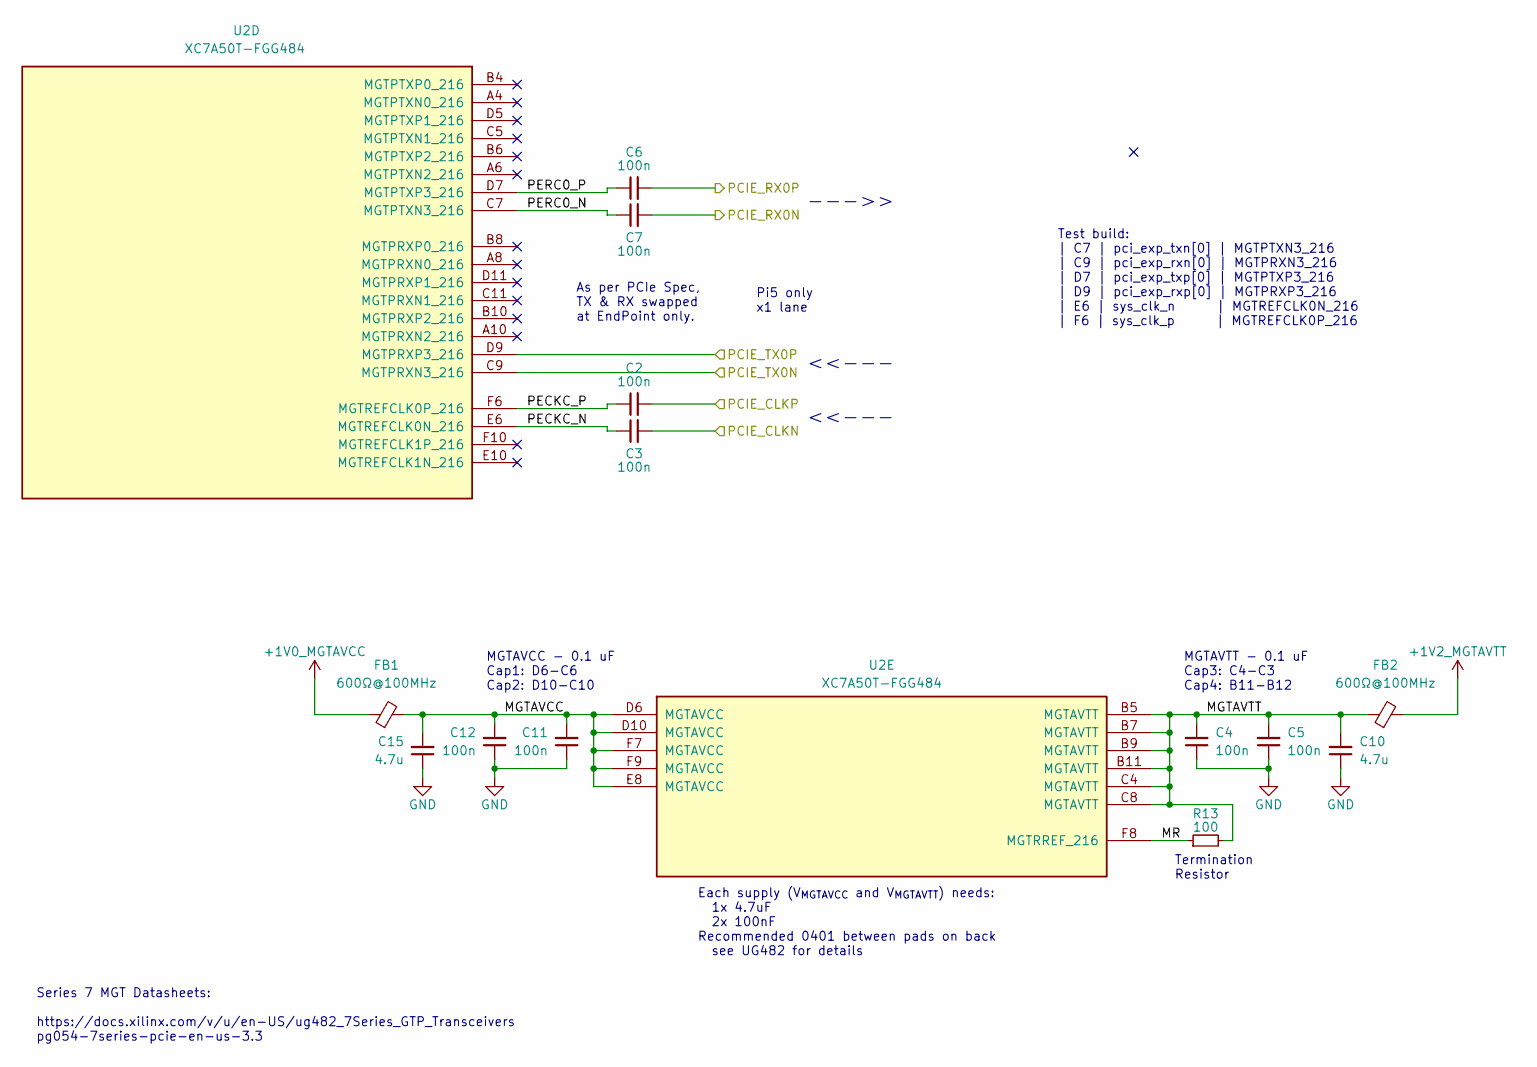
[picture p15: schematic fpga_bank4.kicad_sch, Pi 5 - Artix XC7A50T - PCIe FPGA Hat]

Parts:
C2, C3, C4, C5, C6, C7, C11, C12: 100n; C_0402_1005Metric; LCSC C1525
C10, C15: 4.7u; C_0402_1005Metric; LCSC C23733
FB1, FB2: 600Ω@100MHz; L_0603_1608Metric; LCSC C1002
R13: 100; R_0402_1005Metric; LCSC C25076
U2: XC7A50T-FGG484; Xilinx_FGG484; LCSC C1550658

Connections:
+1V0_MGTAVCC: FB1.1; also elsewhere on the board
+1V2_MGTAVTT: FB2.2; also elsewhere on the board
/FPGA Top/FPGA Bank 216 (MGT)/MGTAVCC: C11.2, C12.2, C15.2, FB1.2, U2.D6 (MGTAVCC), U2.D10 (MGTAVCC), U2.E8 (MGTAVCC), U2.F7 (MGTAVCC), U2.F9 (MGTAVCC)
/FPGA Top/FPGA Bank 216 (MGT)/MGTAVTT: C4.2, C5.2, C10.2, FB2.1, R13.2, U2.B5 (MGTAVTT), U2.B7 (MGTAVTT), U2.B9 (MGTAVTT), U2.B11 (MGTAVTT), U2.C4 (MGTAVTT), U2.C8 (MGTAVTT)
/FPGA Top/FPGA Bank 216 (MGT)/MR: R13.1, U2.F8 (MGTRREF_216)
/FPGA Top/FPGA Bank 216 (MGT)/PECKC_N: C3.1, U2.E6 (MGTREFCLK0N_216)
/FPGA Top/FPGA Bank 216 (MGT)/PECKC_P: C2.1, U2.F6 (MGTREFCLK0P_216)
/FPGA Top/FPGA Bank 216 (MGT)/PERC0_N: C7.1, U2.C7 (MGTPTXN3_216)
/FPGA Top/FPGA Bank 216 (MGT)/PERC0_P: C6.1, U2.D7 (MGTPTXP3_216)
/FPGA Top/PCIE_CLKN: C3.2; also elsewhere on the board
/FPGA Top/PCIE_CLKP: C2.2; also elsewhere on the board
/FPGA Top/PCIE_RX0N: C7.2; also elsewhere on the board
/FPGA Top/PCIE_RX0P: C6.2; also elsewhere on the board
/FPGA Top/PCIE_TX0N: U2.C9 (MGTPRXN3_216); also elsewhere on the board
/FPGA Top/PCIE_TX0P: U2.D9 (MGTPRXP3_216); also elsewhere on the board
GND: C4.1, C5.1, C10.1, C11.1, C12.1, C15.1; also elsewhere on the board

Notes on the sheet:
MGTAVTT - 0.1 uF Cap3: C4-C3 Cap4: B11-B12
Termination Resistor
<<---
Test build: | C7 | pci_exp_txn[0] | MGTPTXN3_216 | C9 | pci_exp_rxn[0] | MGTPRXN3_216 | D7 | pci_exp_txp[0] | MGTPTXP3_216 | D9 | pci_exp_rxp[0] | MGTPRXP3_216 | E6 | sys_clk_n | MGTREFCLK0N_216 | F6 | sys_clk_p | MGTREFCLK0P_216
Series 7 MGT Datasheets: https://docs.xilinx.com/v/u/en-US/ug482_7Series_GTP_Transceivers pg054-7series-pcie-en-us-3.3
Pi5 only x1 lane
--->>
MGTAVCC - 0.1 uF Cap1: D6-C6 Cap2: D10-C10
As per PCIe Spec, TX & RX swapped at EndPoint only.
Each supply (V_{MGTAVCC} and V_{MGTAVTT}) needs: 1x 4.7uF 2x 100nF Recommended 0401 between pads on back see UG482 for details
