goran-mahovlic/Pi5-Artix-FPGA-Hat/PCB/Pi5-Artix50T-Hat.kicad_pcb

## KiCad design PCB/Pi5-Artix50T-Hat.kicad_pcb (continued)

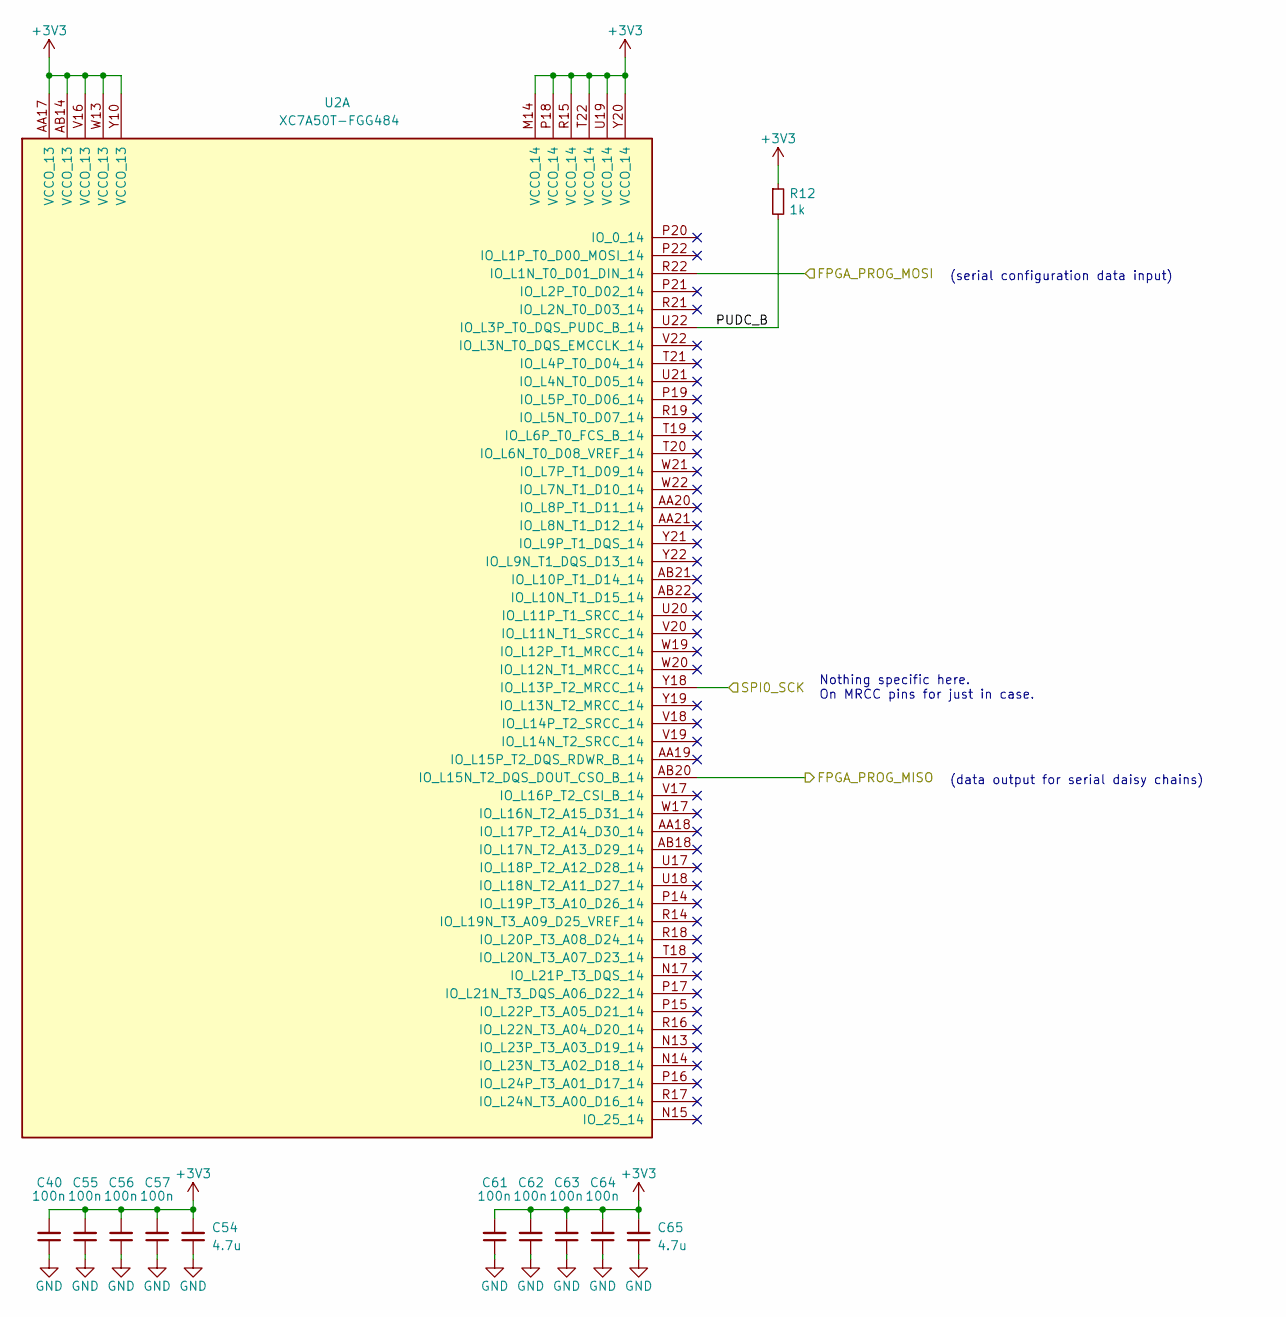
[picture p16: schematic fpga_bank1.kicad_sch, Pi 5 - Artix XC7A50T - PCIe FPGA Hat]

Parts:
C40, C55, C56, C57, C61, C62, C63, C64: 100n; C_0402_1005Metric; LCSC C1525
C54, C65: 4.7u; C_0402_1005Metric; LCSC C23733
R12: 1k; R_0402_1005Metric; LCSC C11702
U2: XC7A50T-FGG484; Xilinx_FGG484; LCSC C1550658

Connections:
+3V3: C40.2, C54.2, C55.2, C56.2, C57.2, C61.2, C62.2, C63.2, C64.2, C65.2, R12.1, U2.AA17 (VCCO_13), U2.AB14 (VCCO_13), U2.M14 (VCCO_14), U2.P18 (VCCO_14), U2.R15 (VCCO_14), U2.T22 (VCCO_14), U2.U19 (VCCO_14), U2.V16 (VCCO_13), U2.W13 (VCCO_13), U2.Y10 (VCCO_13), U2.Y20 (VCCO_14); also elsewhere on the board
/FPGA Top/FPGA Bank 14/PUDC_B: R12.2, U2.U22 (IO_L3P_T0_DQS_PUDC_B_14)
/Raspberry Pi 5/GPIO9/SPI0.MISO: U2.AB20 (IO_L15N_T2_DQS_DOUT_CSO_B_14); also elsewhere on the board
/Raspberry Pi 5/GPIO10/SPI0.MOSI: U2.R22 (IO_L1N_T0_D01_DIN_14); also elsewhere on the board
/Raspberry Pi 5/GPIO11/SPI0.SCLK: U2.Y18 (IO_L13P_T2_MRCC_14); also elsewhere on the board
GND: C40.1, C54.1, C55.1, C56.1, C57.1, C61.1, C62.1, C63.1, C64.1, C65.1; also elsewhere on the board

Notes on the sheet:
(serial configuration data input)
Nothing specific here. On MRCC pins for just in case.
(data output for serial daisy chains)

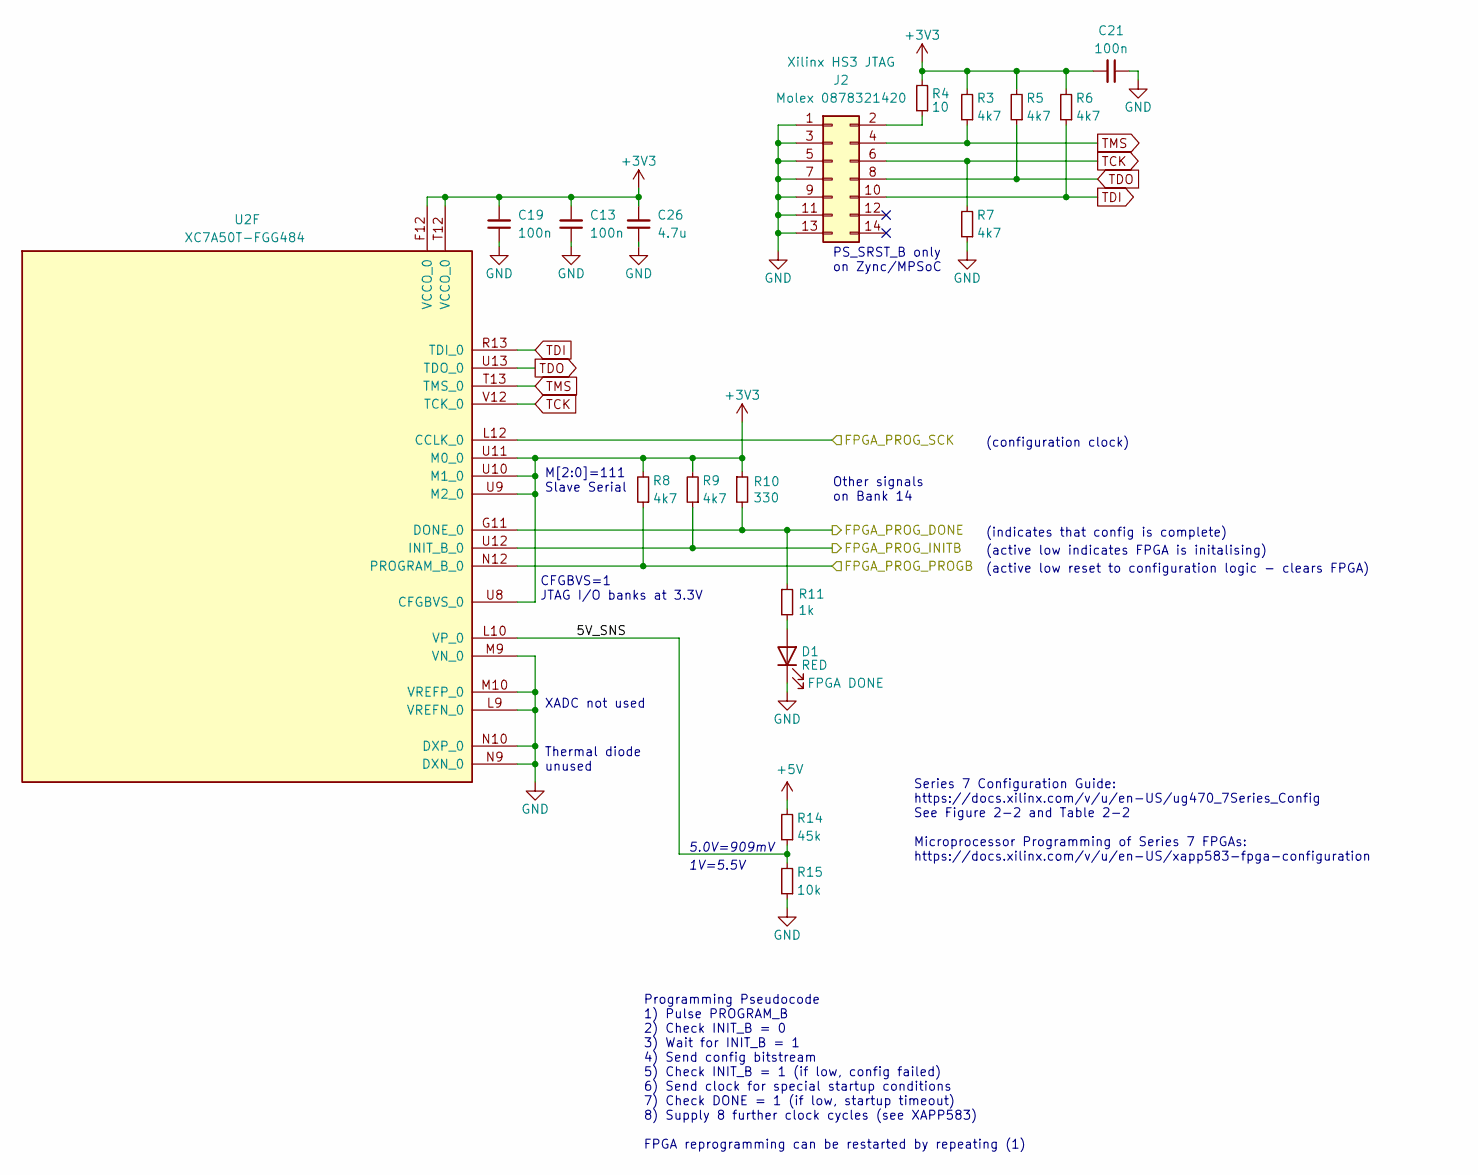
[picture p17: schematic fpga_config.kicad_sch, Pi 5 - Artix XC7A50T - PCIe FPGA Hat]

Parts:
C13, C19, C21: 100n; C_0402_1005Metric; LCSC C1525
C26: 4.7u; C_0402_1005Metric; LCSC C23733
D1: RED; LED_0603_1608Metric; LCSC C965795
J2: Molex 0878321420; PinHeader_2x07_P2.00mm_Vertical; LCSC C225292
R3, R5, R6, R7, R8, R9: 4k7; R_0402_1005Metric; LCSC C25900
R4: 10; R_0402_1005Metric; LCSC C25077
R10: 330; R_0402_1005Metric; LCSC C25104
R11: 1k; R_0402_1005Metric; LCSC C11702
R14: 45k; R_0402_1005Metric; LCSC C25792
R15: 10k; R_0402_1005Metric; LCSC C25744
U2: XC7A50T-FGG484; Xilinx_FGG484; LCSC C1550658

Connections:
+3V3: C13.2, C19.2, C21.2, C26.2, R3.2, R4.2, R5.2, R6.2, R8.2, R9.2, R10.1, U2.F12 (VCCO_0), U2.T12 (VCCO_0), U2.U8 (CFGBVS_0), U2.U9 (M2_0), U2.U10 (M1_0), U2.U11 (M0_0); also elsewhere on the board
+5V: R14.2; also elsewhere on the board
/FPGA Top/FPGA Config/5V_SNS: R14.1, R15.2, U2.L10 (VP_0)
/Raspberry Pi 5/GPIO11/SPI0.SCLK: U2.L12 (CCLK_0); also elsewhere on the board
/Raspberry Pi 5/GPIO23: R10.2, R11.1, U2.G11 (DONE_0); also elsewhere on the board
/Raspberry Pi 5/GPIO24: R9.1, U2.U12 (INIT_B_0); also elsewhere on the board
/Raspberry Pi 5/GPIO25: R8.1, U2.N12 (PROGRAM_B_0); also elsewhere on the board
GND: C13.1, C19.1, C21.1, C26.1, D1.1 (K), J2.1, J2.3, J2.5, J2.7, J2.9, J2.11, J2.13, R7.1, R15.1, U2.L9 (VREFN_0), U2.M9 (VN_0), U2.M10 (VREFP_0), U2.N9 (DXN_0), U2.N10 (DXP_0); also elsewhere on the board
unnamed: D1.2 (A), R11.2
unnamed: J2.2, R4.1
TCK: J2.6, R7.2, U2.V12 (TCK_0)
TDI: J2.10, R6.1, U2.R13 (TDI_0)
TDO: J2.8, R5.1, U2.U13 (TDO_0)
TMS: J2.4, R3.1, U2.T13 (TMS_0)

Notes on the sheet:
(configuration clock)
Other signals on Bank 14
XADC not used
CFGBVS=1 JTAG I/O banks at 3.3V
(indicates that config is complete)
Series 7 Configuration Guide: https://docs.xilinx.com/v/u/en-US/ug470_7Series_Config See Figure 2-2 and Table 2-2 Microprocessor Programming of Series 7 FPGAs: https://docs.xilinx.com/v/u/en-US/xapp583-fpga-configuration
PS_SRST_B only on Zync/MPSoC
M[2:0]=111 Slave Serial
(active low indicates FPGA is initalising)
Thermal diode unused
(active low reset to configuration logic - clears FPGA)
1V=5.5V
5.0V=909mV
Programming Pseudocode 1) Pulse PROGRAM_B 2) Check INIT_B = 0 3) Wait for INIT_B = 1 4) Send config bitstream 5) Check INIT_B = 1 (if low, config failed) 6) Send clock for special startup conditions 7) Check DONE = 1 (if low, startup timeout) 8) Supply 8 further clock cycles (see XAPP583) FPGA repr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

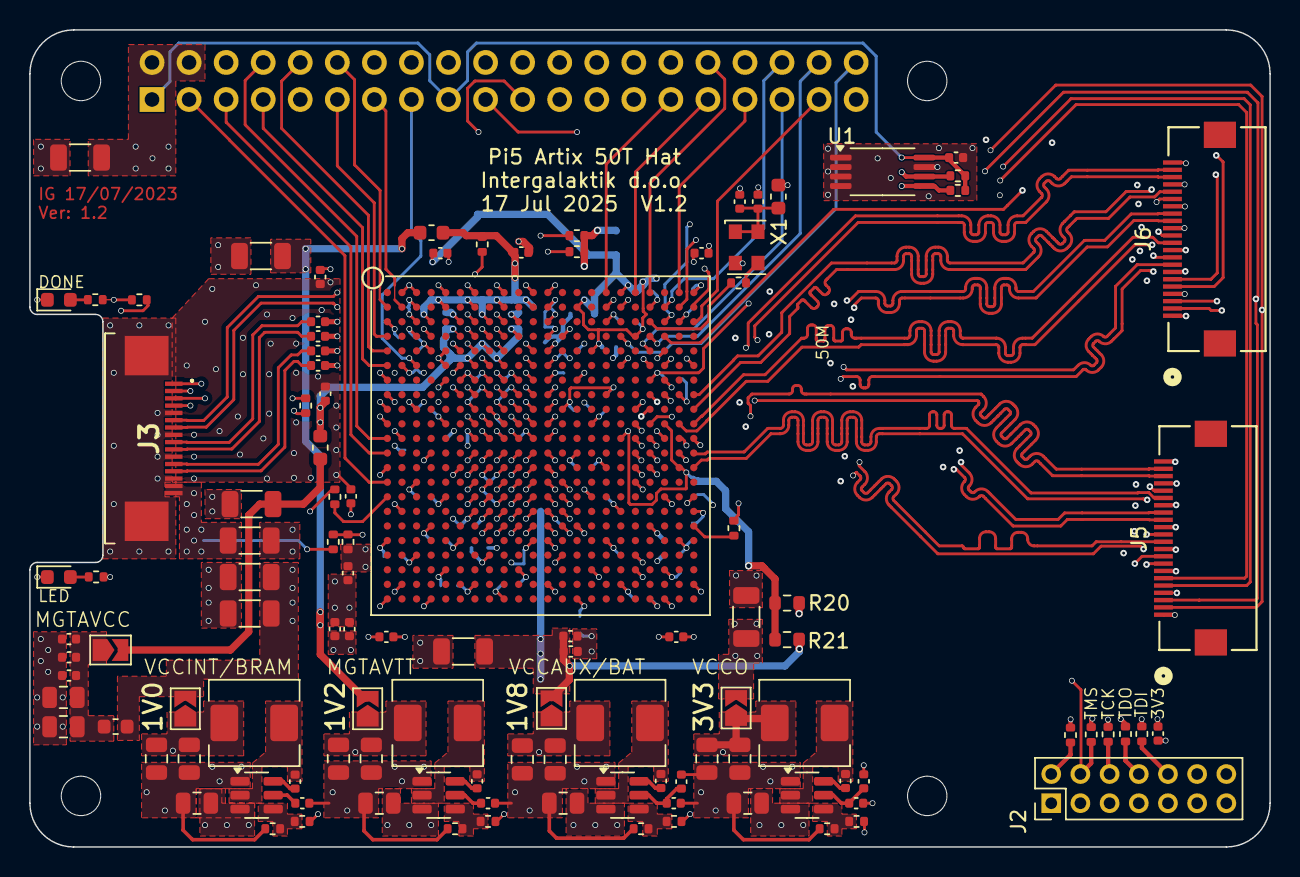
[picture p18: board Pi5-Artix50T-Hat.kicad_pcb from above]

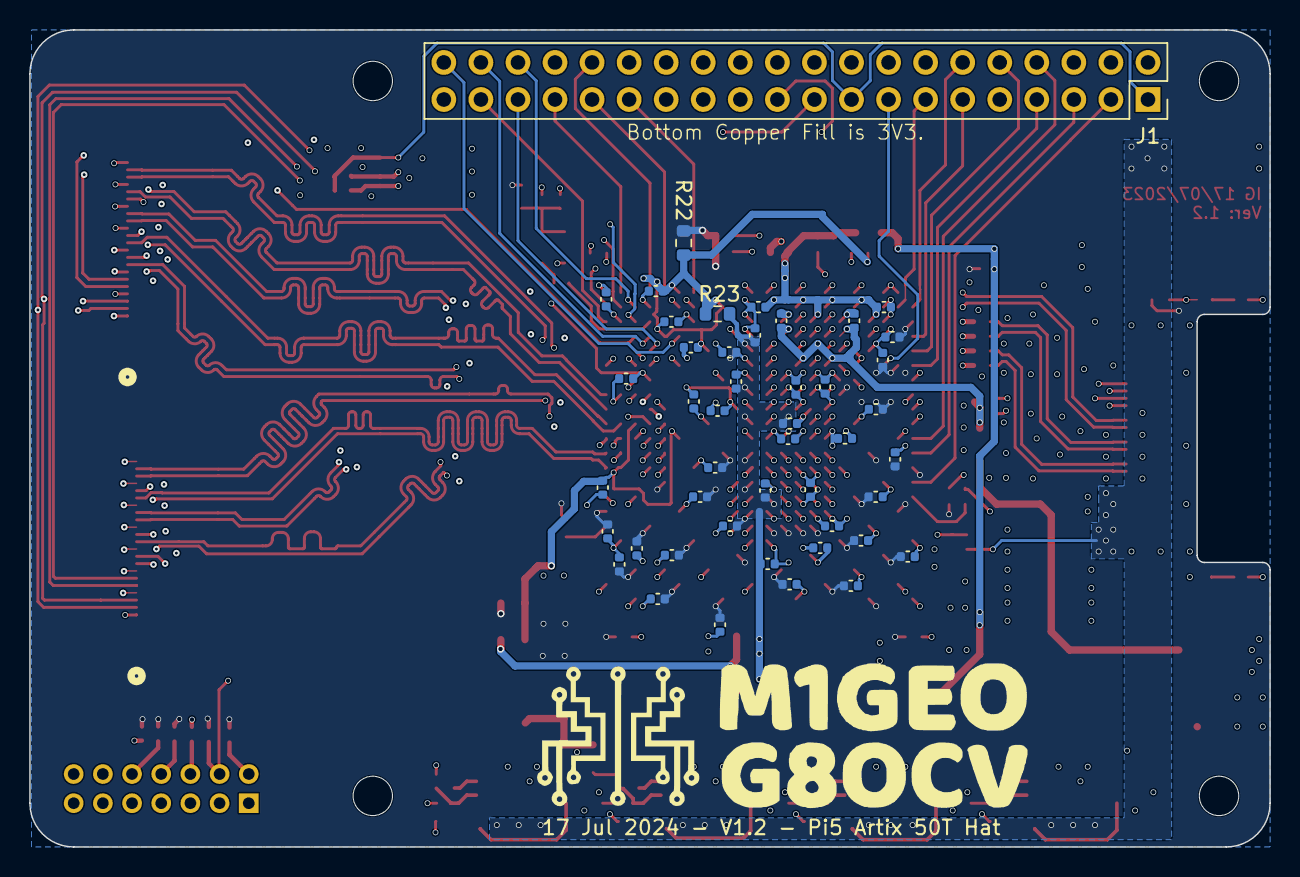
[picture p19: board Pi5-Artix50T-Hat.kicad_pcb from below]

Board: 4 copper layers, 85.0 x 56.0 mm, 161 parts (46 on the bottom side), 117 nets.

Other parts of the board:
MH1, MH2, MH3, MH4: MountingHole_2.7mm_M2.5
