goran-mahovlic/Pi5-Artix-FPGA-Hat/(commit log)

2025-07-16 Connecting and routing diff pairs
    [Pi5-Artix50T-Hat.kicad_pcb, Pi5-Artix50T-Hat.kicad_sch, fpga_bank1.kicad_sch, fpga_bank2.kicad_sch, fpga_bank3.kicad_sch, fpga_bank4.kicad_sch, fpga_config.kicad_sch, fpga_power.kicad_sch]
2025-07-17 connecting JTAG and other non diff pins, routing
    [Pi5-Artix50T-Hat.kicad_pcb, fpga_bank2.kicad_sch]
2025-07-17 Version 1.2 routed
    [Pi5-Artix50T-Hat.kicad_pcb, Pi5-Artix50T-Hat.kicad_sch, fpga_bank1.kicad_sch, fpga_bank2.kicad_sch, fpga_bank3.kicad_sch, fpga_bank4.kicad_sch, fpga_config.kicad_sch, fpga_power.kicad_sch]
2025-07-18 MIPI conectors should be now compatible with C597981
    [Pi5-Artix50T-Hat.kicad_pcb, fpga_bank2.kicad_sch, raspi5.kicad_sch]
2025-07-18 Updating LEDs footprint and Resistors value
    [Pi5-Artix50T-Hat.kicad_pcb, fpga_bank2.kicad_sch, fpga_bank3.kicad_sch, fpga_config.kicad_sch, fpga_top.kicad_sch, raspi5.kicad_sch]
2025-07-19 updating connector
    [Pi5-Artix50T-Hat.kicad_pcb, fpga_bank2.kicad_sch]
